AUautosynth/AU-ASM/README.md

Checkout the releases corresponding to the article you came from to get the code and setup information needed to build a machine for yourself.
