AUautosynth/AU-ASM/Towards the automation of nanoparticle syntheses/README.md

# Automatic Synthesis Machine

The purpose of this project is to create a low cost open-source machine for the automation of laboratory work.



## Description

The machine (ASM) consists of a modified 3D printer that can run up to 45 stirred batch reactions at 5.5 ml 
capacity mixing up to 5 different solutions in inert atmosphere. The machine can be seen below.

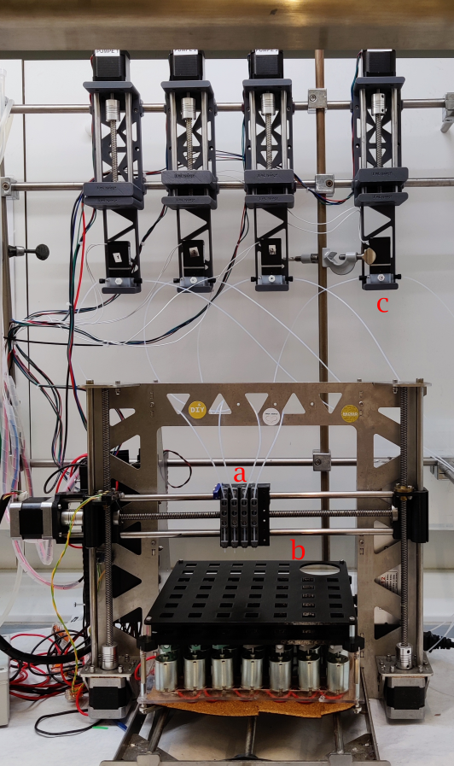
[picture p1: Towards the automation of nanoparticle syntheses/assets/images/Assembledmachine.png]
The machine


The ASM can be seen in the picture above, the new additions have been marked where ***a*** is the dosing head, ***b*** is the cuvette module, 
***c*** are the pumps hanging on fumehood monkey bars.

The estimated cost of the machine is below 2500 EUR, see BoM under assets.
The layout and controlling python scrpit makes it easy to create your own protocols but a standard mixing protocol as well as a 
calibration protocol is already made. To setup and install your own ASM, checkout the PDF guide written. In there, the hardware and software is explained in depth.
The current machine is made up in modules, so that its capabilities can be interchanged based on your needs.

### Modules
The modules of the ASM includes:
- [x] Dosing
- [x] Stirring
- [x] Atmospheric control

## Getting Started

### Dependencies

* Latest [arduino IDE](https://www.arduino.cc/en/software).
* [Python 3.9.7](https://www.python.org/downloads/) or higher.
* For script usage we recommend using either the latest version of [spyder](https://www.spyder-ide.org/) or [pycharm community edition](https://www.jetbrains.com/pycharm/download/#section=windows).
* A 3D printer with a modifiable PCB ([Preferably Ramps 1.4](https://reprap.org/wiki/RAMPS_1.4))
* All necessary CAD and STL files can be found under assets

### Installing

- Download the repository as a .zip file and extract it into a folder.
- Install the modified Marlin firmware on the 3D printer PCB found in the firmware folder.

### Using the machine
This shows a standard procedure for the operation of an experiment using the machine.

1. Create the experiment protocol.
2. Add vials and tubing to the machine.
3. Prepare the stock solutions.
4. Press run.

## Authors
Jakob Saugbjerg (jrs@bce.au.dk)

Thorbjørn Jensen (tbj@bce.au.dk)

Mogens Hinge (hinge@bce.au.dk)

Martin Lahn (lahn@bce.au.dk)

## Version History

* 2.0
   * Integrated the protocol creator into the python software
   * Added a timed start to the protocol
   * Added a control feature to adjust the X, Y and Z axis.
   * Adjusted the pump setup so they can pump high viscosity liquids (Glycose 80%) and smaller dosings (20 microliters)

* 1.0
    * Initial Release

## License

MIT License

Copyright (c) 2023 Jakob Rørbæk Saugbjerg, Thorbjørn Bøgh Jensen, Mogens Hinge & Martin Lahn

Permission is hereby granted, free of charge, to any person obtaining a copy
of this software and associated documentation files (the "Software"), to deal
in the Software without restriction, including without limitation the rights
to use, copy, modify, merge, publish, distribute, sublicense, and/or sell
copies of the Software, and to permit persons to whom the Software is
furnished to do so, subject to the following conditions:

The above copyright notice and this permission notice shall be included in all
copies or substantial portions of the Software.

THE SOFTWARE IS PROVIDED "AS IS", WITHOUT WARRANTY OF ANY KIND, EXPRESS OR
IMPLIED, INCLUDING BUT NOT LIMITED TO THE WARRANTIES OF MERCHANTABILITY,
FITNESS FOR A PARTICULAR PURPOSE AND NONINFRINGEMENT. IN NO EVENT SHALL THE
AUTHORS OR COPYRIGHT HOLDERS BE LIABLE FOR ANY CLAIM, DAMAGES OR OTHER
LIABILITY, WHETHER IN AN ACTION OF CONTRACT, TORT OR OTHERWISE, ARISING FROM,
OUT OF OR IN CONNECTION WITH THE SOFTWARE OR THE USE OR OTHER DEALINGS IN THE
SOFTWARE.
