AUautosynth/AU-ASM/A modular low-cost ASM demonstrated by ROMP/assets/BoM/BoM.xlsx

BoM:
Description | Quantity | Location | Notes | Cost [DKK]
General
3D printer | 1 |  | We used a Prisa i3 clone with an Arduino Mega and a Ramps 1.4 shield attached | 3 500
1.75 mm PLA filament | 1 spool (1 000 g) |  | For production of barious parts | 170
Wires | a lot |  |  | 36
RampsXB | 1 | Attachment to the Ramps 1.4 shield | RampsXB is an experied product, similar boards can be used (e.g. Ramps stepper expander) | -
M3 screws | a lot | All threads are made for m# screws in various lengths | Get a set from 3 to 20 mm | 150
Mechanical end-stop |  | Replaces the induction sensor for the Z.axis |  | 80
Polycarbonate sheets, 3mm | about 1 m2 | Stirring and inert modules |  | 299
Dosage module
Custom pump | 1-5 | Attaches to the machine | Similar pump sustems can be used | 500 per pump
Bükert three-way solenoid valve | 1 per pump | Placed on the pump | Controls the flow direction | 1 061
Tube fittings | 3 per valve | Fits the ports on the valve |  | 66
Silicone tubing 4 mm ID | a lot | Pump module | Connects stock solutions to the machine | 450 for 7.6 m
BlueCap flask 250 mL | 1 per pump | Connected to the valve | Contains stock solution | 25 per flask
Special cannula | 1 per pump | Connects the BlueCap to tubing |  | 20 per needle
Rubber septum | 1 per pump | BlueCap lid | Selas the modified BlueCap lid | 20 per septum
50 x 0.8 mm 21g sterile syringe | 1 box (100 pcs) | In the needle module | Different needles can be used with slight modifications | 34
Stirring module
12 DC motors | 45 | Stirring module |  | 1 750
Teflon coated magnets 20x6 mm | 45 | Stirring module |  | 608
Teflon coated 45 magnets 15x4.5 mm | 45 | Stirring module |  | 428
PWM controller | 3 | Stirring module |  | 300
ABS box | 1 | Stirring module | Holds the PWM controllers | 79
Atmosphere control module
Luer lock male and female set | 10 sets | In the silicone tubing and for gas inlet in the atmosphere control module |  | 100
Total cost | With 1 pump |  |  | 9 676 ≈ 1 300 EUR
 | With 5 pumps |  |  | 16 439 ≈ 2 205 EUR
