AUautosynth/AU-ASM/A modular low-cost ASM demonstrated by ROMP/assets/STL files/needle holder.stl

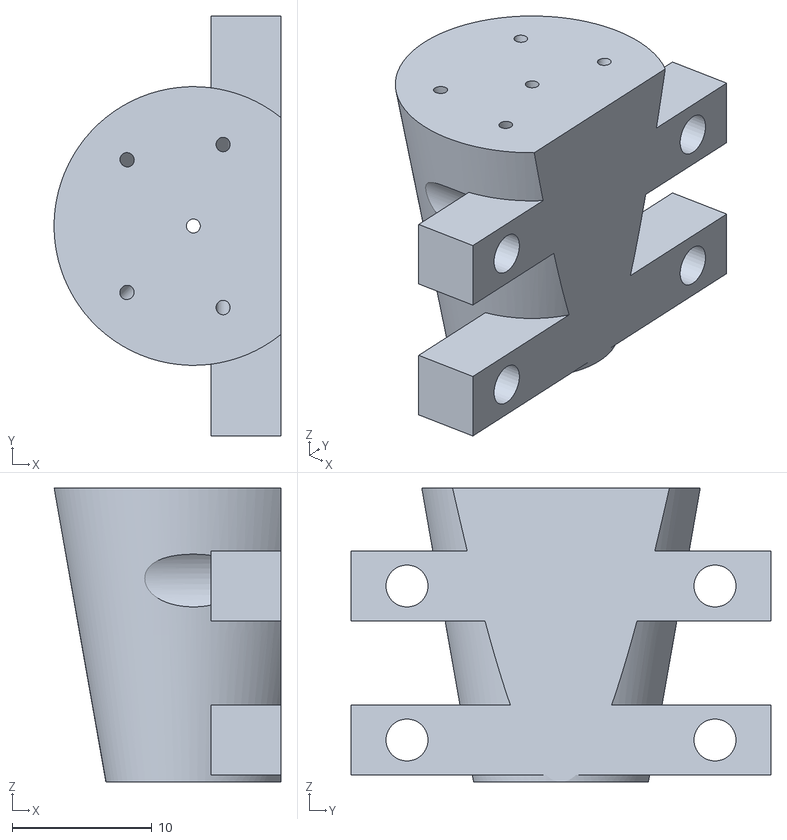
[picture p3: CAD file, 2023-05-10]
A modular low-cost ASM demonstrated by ROMP/assets/STL files/needle holder.stl
16.2 x 30.0 x 21.0
