AUautosynth/AU-ASM/assets/STL files/pump modification.stl

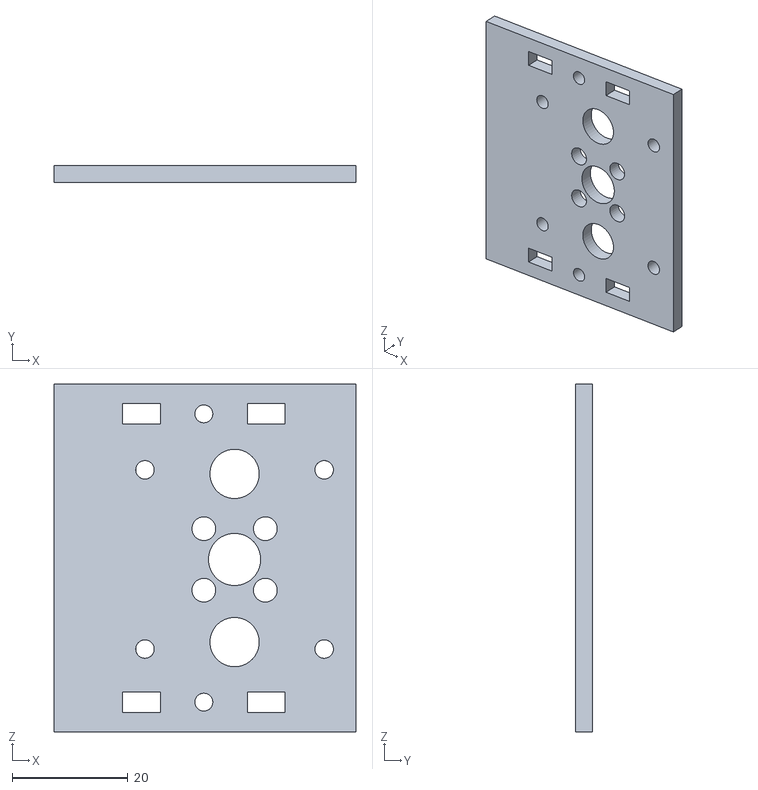
[picture p4: CAD file, 2023-05-10]
assets/STL files/pump modification.stl
52.0 x 3.00 x 60.0
