AUautosynth/AU-ASM/Towards the automation of nanoparticle syntheses/assets/IPT/DH_Gantry.stl

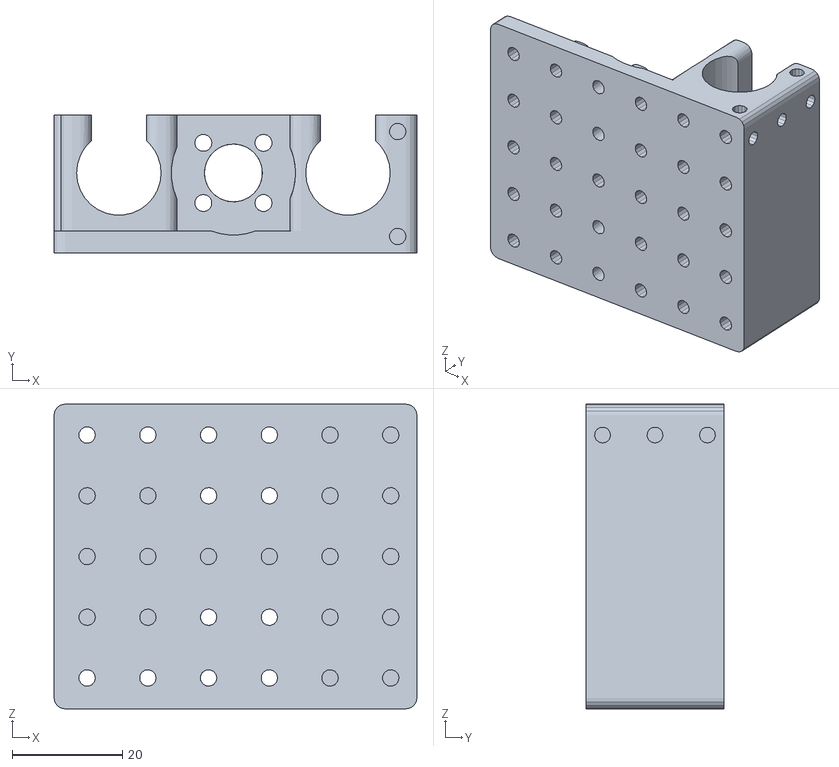
[picture p6: CAD file, 2023-10-06]
Towards the automation of nanoparticle syntheses/assets/IPT/DH_Gantry.stl
65.8 x 25.0 x 55.2
