AUautosynth/AU-ASM/A modular low-cost ASM demonstrated by ROMP/assets/STL files/X-endstop bar.stl

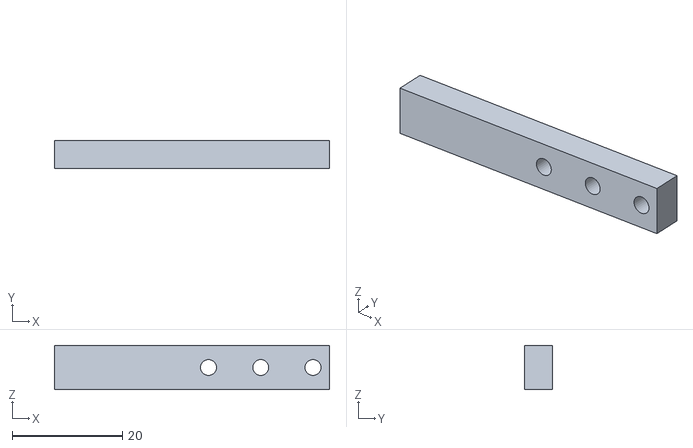
[picture p7: CAD file, 2023-05-10]
A modular low-cost ASM demonstrated by ROMP/assets/STL files/X-endstop bar.stl
50.0 x 5.00 x 8.00
