AUautosynth/AU-ASM/Towards the automation of nanoparticle syntheses/assets/IPT/CM_top.stl

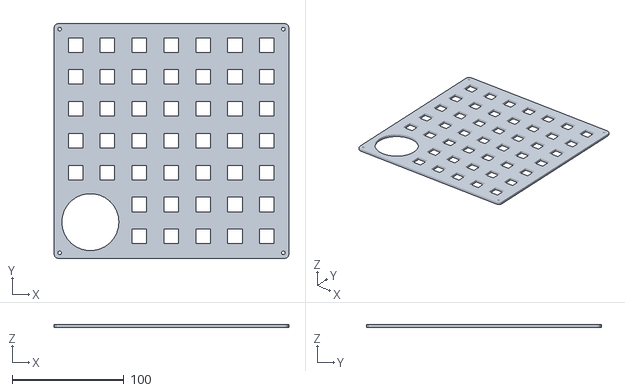
[picture p9: CAD file, 2023-10-06]
Towards the automation of nanoparticle syntheses/assets/IPT/CM_top.stl
210.0 x 210.0 x 3.00
