AUautosynth/AU-ASM/A modular low-cost ASM demonstrated by ROMP/assets/STL files/valve fixture.stl

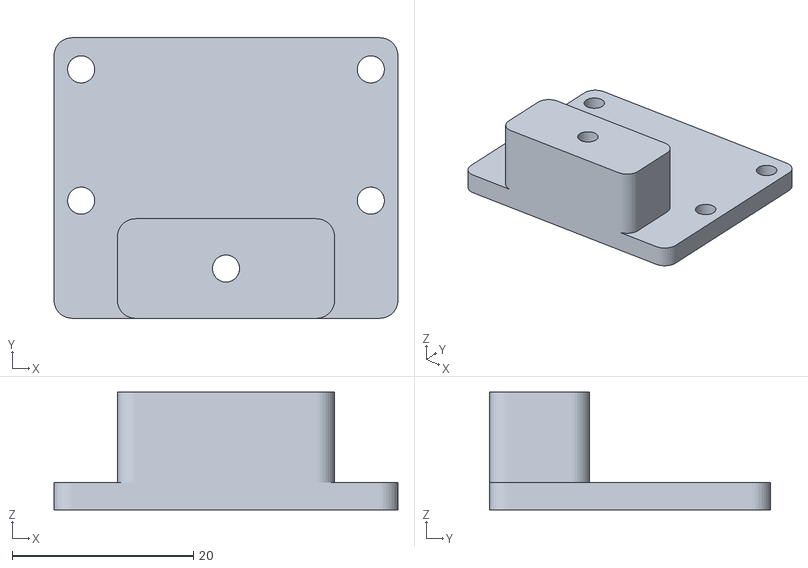
[picture p10: CAD file, 2023-05-10]
A modular low-cost ASM demonstrated by ROMP/assets/STL files/valve fixture.stl
38.0 x 31.0 x 13.0
