AUautosynth/AU-ASM/assets/STL files/magnet fixture.stl

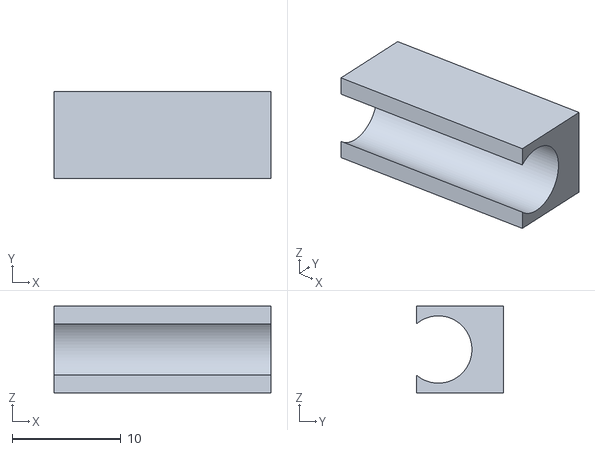
[picture p11: CAD file, 2023-05-10]
assets/STL files/magnet fixture.stl
20.0 x 8.00 x 8.00
