AUautosynth/AU-ASM/The Perry project A Versatile Low-Cost Syringe Pump for Dispensing in Automated Synthesis Systems/STL/Perry_syringe_fitter_5mL.stl

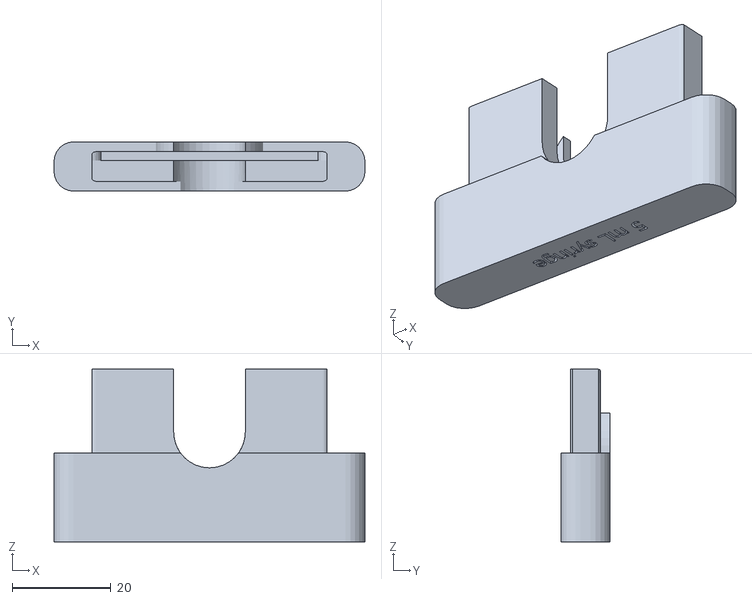
[picture p12: CAD file, 2023-10-06]
The Perry project A Versatile Low-Cost Syringe Pump for Dispensing in Automated Synthesis Systems/STL/Perry_syringe_fitter_5mL.stl
63.0 x 10.0 x 35.0
