AUautosynth/AU-ASM/Towards the automation of nanoparticle syntheses/assets/IPT/DH_tubing_holder.stl

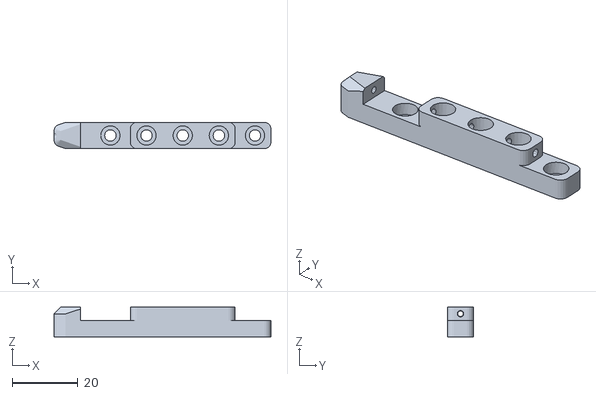
[picture p13: CAD file, 2023-10-06]
Towards the automation of nanoparticle syntheses/assets/IPT/DH_tubing_holder.stl
66.0 x 8.00 x 9.00
