AUautosynth/AU-ASM/A modular low-cost ASM demonstrated by ROMP/assets/STL files/pump sledge.stl

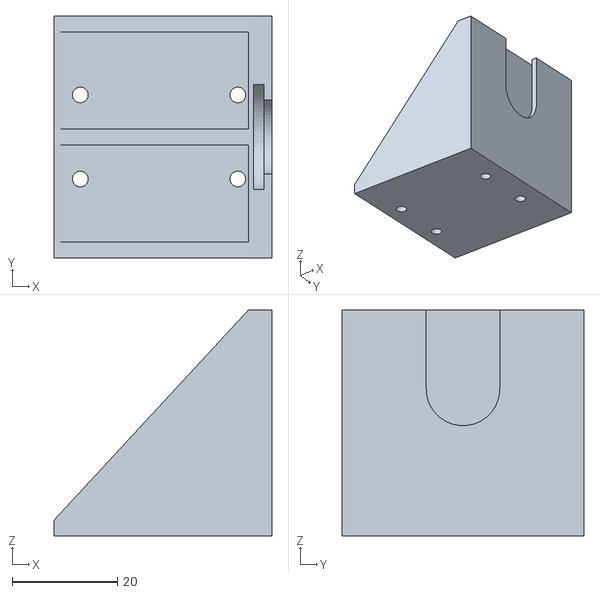
[picture p14: CAD file, 2023-05-10]
A modular low-cost ASM demonstrated by ROMP/assets/STL files/pump sledge.stl
41.5 x 46.0 x 43.0
