AUautosynth/AU-ASM/The Perry project A Versatile Low-Cost Syringe Pump for Dispensing in Automated Synthesis Systems/STL/Perry_plunge_fitter_5ml.stl

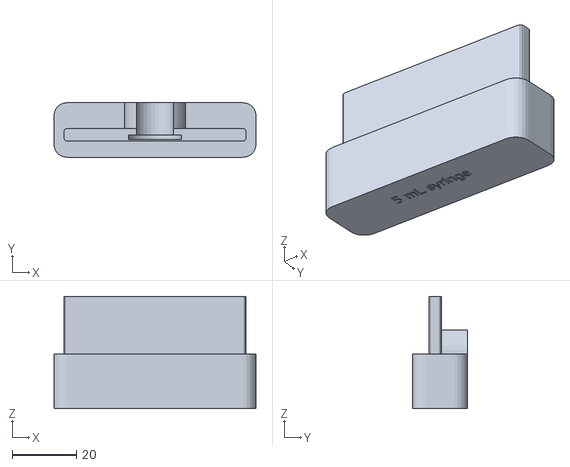
[picture p15: CAD file, 2023-10-06]
The Perry project A Versatile Low-Cost Syringe Pump for Dispensing in Automated Synthesis Systems/STL/Perry_plunge_fitter_5ml.stl
63.0 x 17.0 x 35.0
