AUautosynth/AU-ASM/Towards the automation of nanoparticle syntheses/assets/IPT/CM_bottom.stl

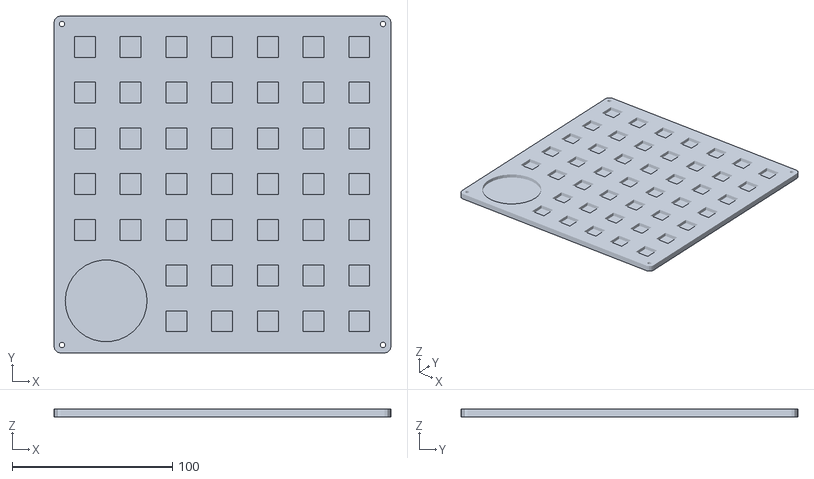
[picture p16: CAD file, 2023-10-06]
Towards the automation of nanoparticle syntheses/assets/IPT/CM_bottom.stl
210.0 x 210.0 x 5.00
