AUautosynth/AU-ASM/Towards the automation of nanoparticle syntheses/assets/IPT/CM_corner_piece.stl

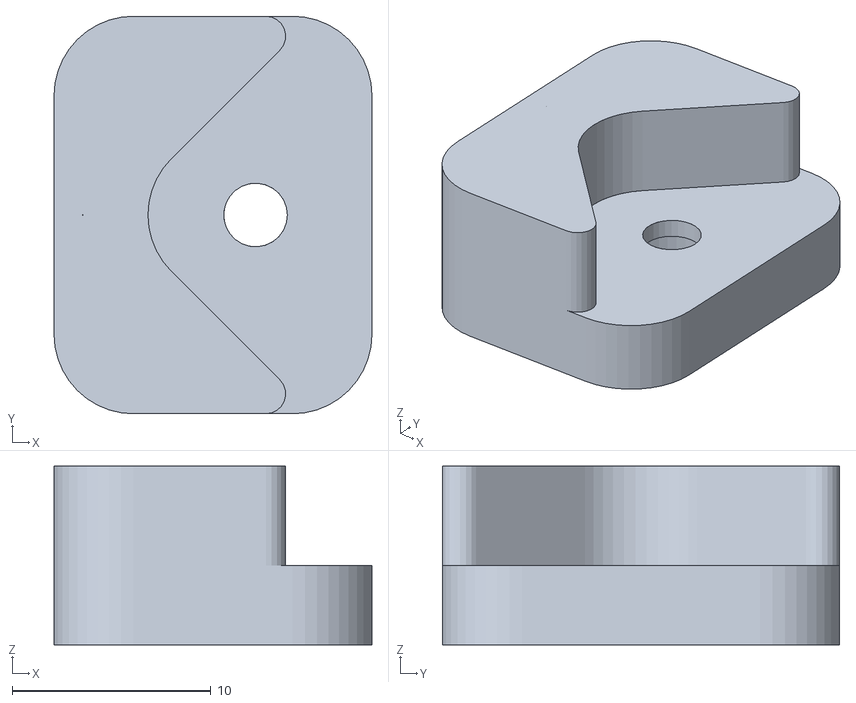
[picture p18: CAD file, 2023-10-06]
Towards the automation of nanoparticle syntheses/assets/IPT/CM_corner_piece.stl
16.0 x 20.0 x 9.00
