AUautosynth/AU-ASM/(list of files, cad)

Other CAD files:
A modular low-cost ASM demonstrated by ROMP/assets/STL files/X-carriage.stl
assets/STL files/X-carriage.stl
The Perry project A Versatile Low-Cost Syringe Pump for Dispensing in Automated Synthesis Systems/STL/Perry_plunge_fitter_20ml.stl
A modular low-cost ASM demonstrated by ROMP/assets/CAD files/ACM_BasePlate.ipt
A modular low-cost ASM demonstrated by ROMP/assets/CAD files/ACM_InsertPlate.ipt
A modular low-cost ASM demonstrated by ROMP/assets/CAD files/ACM_Lid.ipt
A modular low-cost ASM demonstrated by ROMP/assets/CAD files/ACM_Side.ipt
A modular low-cost ASM demonstrated by ROMP/assets/CAD files/ACM_SupportColumn1.ipt
A modular low-cost ASM demonstrated by ROMP/assets/CAD files/ACM_SupportColumn2.ipt
A modular low-cost ASM demonstrated by ROMP/assets/CAD files/DM_DirectMotorMount.ipt
A modular low-cost ASM demonstrated by ROMP/assets/CAD files/DM_NeedleHolder.ipt
A modular low-cost ASM demonstrated by ROMP/assets/CAD files/SM_DCholder.ipt
A modular low-cost ASM demonstrated by ROMP/assets/CAD files/SM_MagnetHolder.ipt
The Perry project A Versatile Low-Cost Syringe Pump for Dispensing in Automated Synthesis Systems/Assembly/Perry_Assembly.iam
The Perry project A Versatile Low-Cost Syringe Pump for Dispensing in Automated Synthesis Systems/IPT/Perry_body.ipt
The Perry project A Versatile Low-Cost Syringe Pump for Dispensing in Automated Synthesis Systems/IPT/Perry_hanger_left.ipt
The Perry project A Versatile Low-Cost Syringe Pump for Dispensing in Automated Synthesis Systems/IPT/Perry_hanger_right.ipt
The Perry project A Versatile Low-Cost Syringe Pump for Dispensing in Automated Synthesis Systems/IPT/Perry_plunge_fitter_10ml.ipt
The Perry project A Versatile Low-Cost Syringe Pump for Dispensing in Automated Synthesis Systems/IPT/Perry_plunge_fitter_1ml.ipt
The Perry project A Versatile Low-Cost Syringe Pump for Dispensing in Automated Synthesis Systems/IPT/Perry_plunge_fitter_20ml.ipt
The Perry project A Versatile Low-Cost Syringe Pump for Dispensing in Automated Synthesis Systems/IPT/Perry_plunge_fitter_2ml.ipt
The Perry project A Versatile Low-Cost Syringe Pump for Dispensing in Automated Synthesis Systems/IPT/Perry_plunge_fitter_5ml.ipt
The Perry project A Versatile Low-Cost Syringe Pump for Dispensing in Automated Synthesis Systems/IPT/Perry_plunger.ipt
The Perry project A Versatile Low-Cost Syringe Pump for Dispensing in Automated Synthesis Systems/IPT/Perry_syringe_fitter_10mL.ipt
The Perry project A Versatile Low-Cost Syringe Pump for Dispensing in Automated Synthesis Systems/IPT/Perry_syringe_fitter_1mL.ipt
The Perry project A Versatile Low-Cost Syringe Pump for Dispensing in Automated Synthesis Systems/IPT/Perry_syringe_fitter_20mL.ipt
The Perry project A Versatile Low-Cost Syringe Pump for Dispensing in Automated Synthesis Systems/IPT/Perry_syringe_fitter_2mL.ipt
The Perry project A Versatile Low-Cost Syringe Pump for Dispensing in Automated Synthesis Systems/IPT/Perry_syringe_fitter_5mL.ipt
The Perry project A Versatile Low-Cost Syringe Pump for Dispensing in Automated Synthesis Systems/IPT/Perry_valve_fixture.ipt
Towards the automation of nanoparticle syntheses/assets/Assembly/CM_Assembly.iam
Towards the automation of nanoparticle syntheses/assets/Assembly/CM_Assembly_Presentation.idw
Towards the automation of nanoparticle syntheses/assets/Assembly/DH_Assembly.iam
Towards the automation of nanoparticle syntheses/assets/Assembly/DH_Assembly_Presentation.idw
Towards the automation of nanoparticle syntheses/assets/Assembly/Perry_Assembly.iam
Towards the automation of nanoparticle syntheses/assets/Assembly/Perry_Assembly_Presentation.idw
Towards the automation of nanoparticle syntheses/assets/IPT/CM_bottom.ipt
Towards the automation of nanoparticle syntheses/assets/IPT/CM_corner_piece.ipt
Towards the automation of nanoparticle syntheses/assets/IPT/CM_top.ipt
Towards the automation of nanoparticle syntheses/assets/IPT/DH_Gantry.ipt
Towards the automation of nanoparticle syntheses/assets/IPT/DH_tubing_holder.ipt
assets/CAD files/ACM_BasePlate.ipt
assets/CAD files/ACM_InsertPlate.ipt
assets/CAD files/ACM_Lid.ipt
assets/CAD files/ACM_Side.ipt
assets/CAD files/ACM_SupportColumn1.ipt
assets/CAD files/ACM_SupportColumn2.ipt
assets/CAD files/DM_DirectMotorMount.ipt
assets/CAD files/DM_NeedleHolder.ipt
assets/CAD files/SM_DCholder.ipt
assets/CAD files/SM_MagnetHolder.ipt
