AUautosynth/AU-ASM/Towards the automation of nanoparticle syntheses/main program/saved protocols/test protocols/Pump calibration - valve_pump.txt

Dosing Method: pump_calibration
Reaction module: Cuvette module
Number of reaction vessels: 45
Max Volume: 3.0
Waste: [180, 180]
Beaker height: 25
Safety height: 65
Vial height: 3
Machine speed: 50
Pump 1: 
index	Solution 1	x-coordinate	y-coordinate
Experiment 1	0.1	28	16.0
Experiment 2	0.5	56	16.0
Experiment 3	0.9	84	16.0
Experiment 4	1.2	113	16.0
Experiment 5	1.5	142	16.0
Experiment 1	0.1	171	16.0
Experiment 2	0.5	199	16.0
Experiment 3	0.9	28	44.0
Experiment 4	1.2	56	44.0
Experiment 5	1.5	84	44.0
Experiment 1	0.1	113	44.0
Experiment 2	0.5	142	44.0
Experiment 3	0.9	171	44.0
Experiment 4	1.2	199	44.0
Experiment 5	1.5	28	72.0
	nan	28	72.0
	nan	56	72.0
	nan	84  72	nan
	nan	113	72.0
	nan	142 72	nan
	nan	171	72.0
	nan	199	100.0
	nan	28  100	nan
	nan	56	100.0
	nan	84	100.0
	nan	113	100.0
	nan	142	100.0
	nan	171	100.0
	nan	199	129.0
	nan	28  129	nan
	nan	56	129.0
	nan	84  129	nan
	nan	113	129.0
	nan	142 129	nan
	nan	171	129.0
	nan	199	129.0
	nan	28 	158.0
	nan	56	158.0
	nan	84 	158.0
	nan	113	158.0
	nan	142	158.0
	nan	28 	186.0
	nan	56	186.0
	nan	84 	186.0
	nan	113	186.0
	nan	142 186	nan
