AUautosynth/AU-ASM/ASM files/Protocol templates/Calibration template.xlsx

Sheet: Dosing sheet
Vials | sol 1 | sol 2 | sol 3 | sol 4 | sol 5 | sol 6 | Totale_volume | x | y
vial 1 | 5 | 0 | 0 | 0 | 0 | 0 | 5 | 18.5 | 11
vial 2 | 5 | 0 | 0 | 0 | 0 | 0 | 5 | 47 | 10.5
vial 3 | 15 | 0 | 0 | 0 | 0 | 0 | 15 | 76 | 10.5
vial 4 | 13 | 0 | 0 | 0 | 0 | 0 | 13 | 104 | 10.5
vial 5 | 2 | 0 | 0 | 0 | 0 | 0 | 2 | 132.5 | 10
vial 6 | 11 | 0 | 0 | 0 | 0 | 0 | 11 | 160 | 10.5
vial 7 | 1 | 0 | 0 | 0 | 0 | 0 | 1 | 189 | 9.5
vial 8 | 20 | 0 | 0 | 0 | 0 | 0 | 20 | 18.5 | 39
vial 9 | 15 | 0 | 0 | 0 | 0 | 0 | 15 | 47 | 39
vial 10 | 13 | 0 | 0 | 0 | 0 | 0 | 13 | 75.5 | 39
vial 11 | 9 | 0 | 0 | 0 | 0 | 0 | 9 | 104.5 | 38
vial 12 | 9 | 0 | 0 | 0 | 0 | 0 | 9 | 132.5 | 38
vial 13 | 4 | 0 | 0 | 0 | 0 | 0 | 4 | 160 | 38
vial 14 | 2 | 0 | 0 | 0 | 0 | 0 | 2 | 189 | 38
vial 15 | 2 | 0 | 0 | 0 | 0 | 0 | 2 | 18 | 67.5
vial 16 | 3 | 0 | 0 | 0 | 0 | 0 | 3 | 48.5 | 67.5
vial 17 | 11 | 0 | 0 | 0 | 0 | 0 | 11 | 76 | 67.5
vial 18 | 13 | 0 | 0 | 0 | 0 | 0 | 13 | 104 | 67
vial 19 | 1 | 0 | 0 | 0 | 0 | 0 | 1 | 132 | 67
vial 20 | 5 | 0 | 0 | 0 | 0 | 0 | 5 | 161 | 66.5
vial 21 | 3 | 0 | 0 | 0 | 0 | 0 | 3 | 189 | 66.5
vial 22 | 15 | 0 | 0 | 0 | 0 | 0 | 15 | 19.5 | 95.75
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
