AUautosynth/AU-ASM/The Perry project A Versatile Low-Cost Syringe Pump for Dispensing in Automated Synthesis Systems/Assembly/Perry_Assembly.pdf

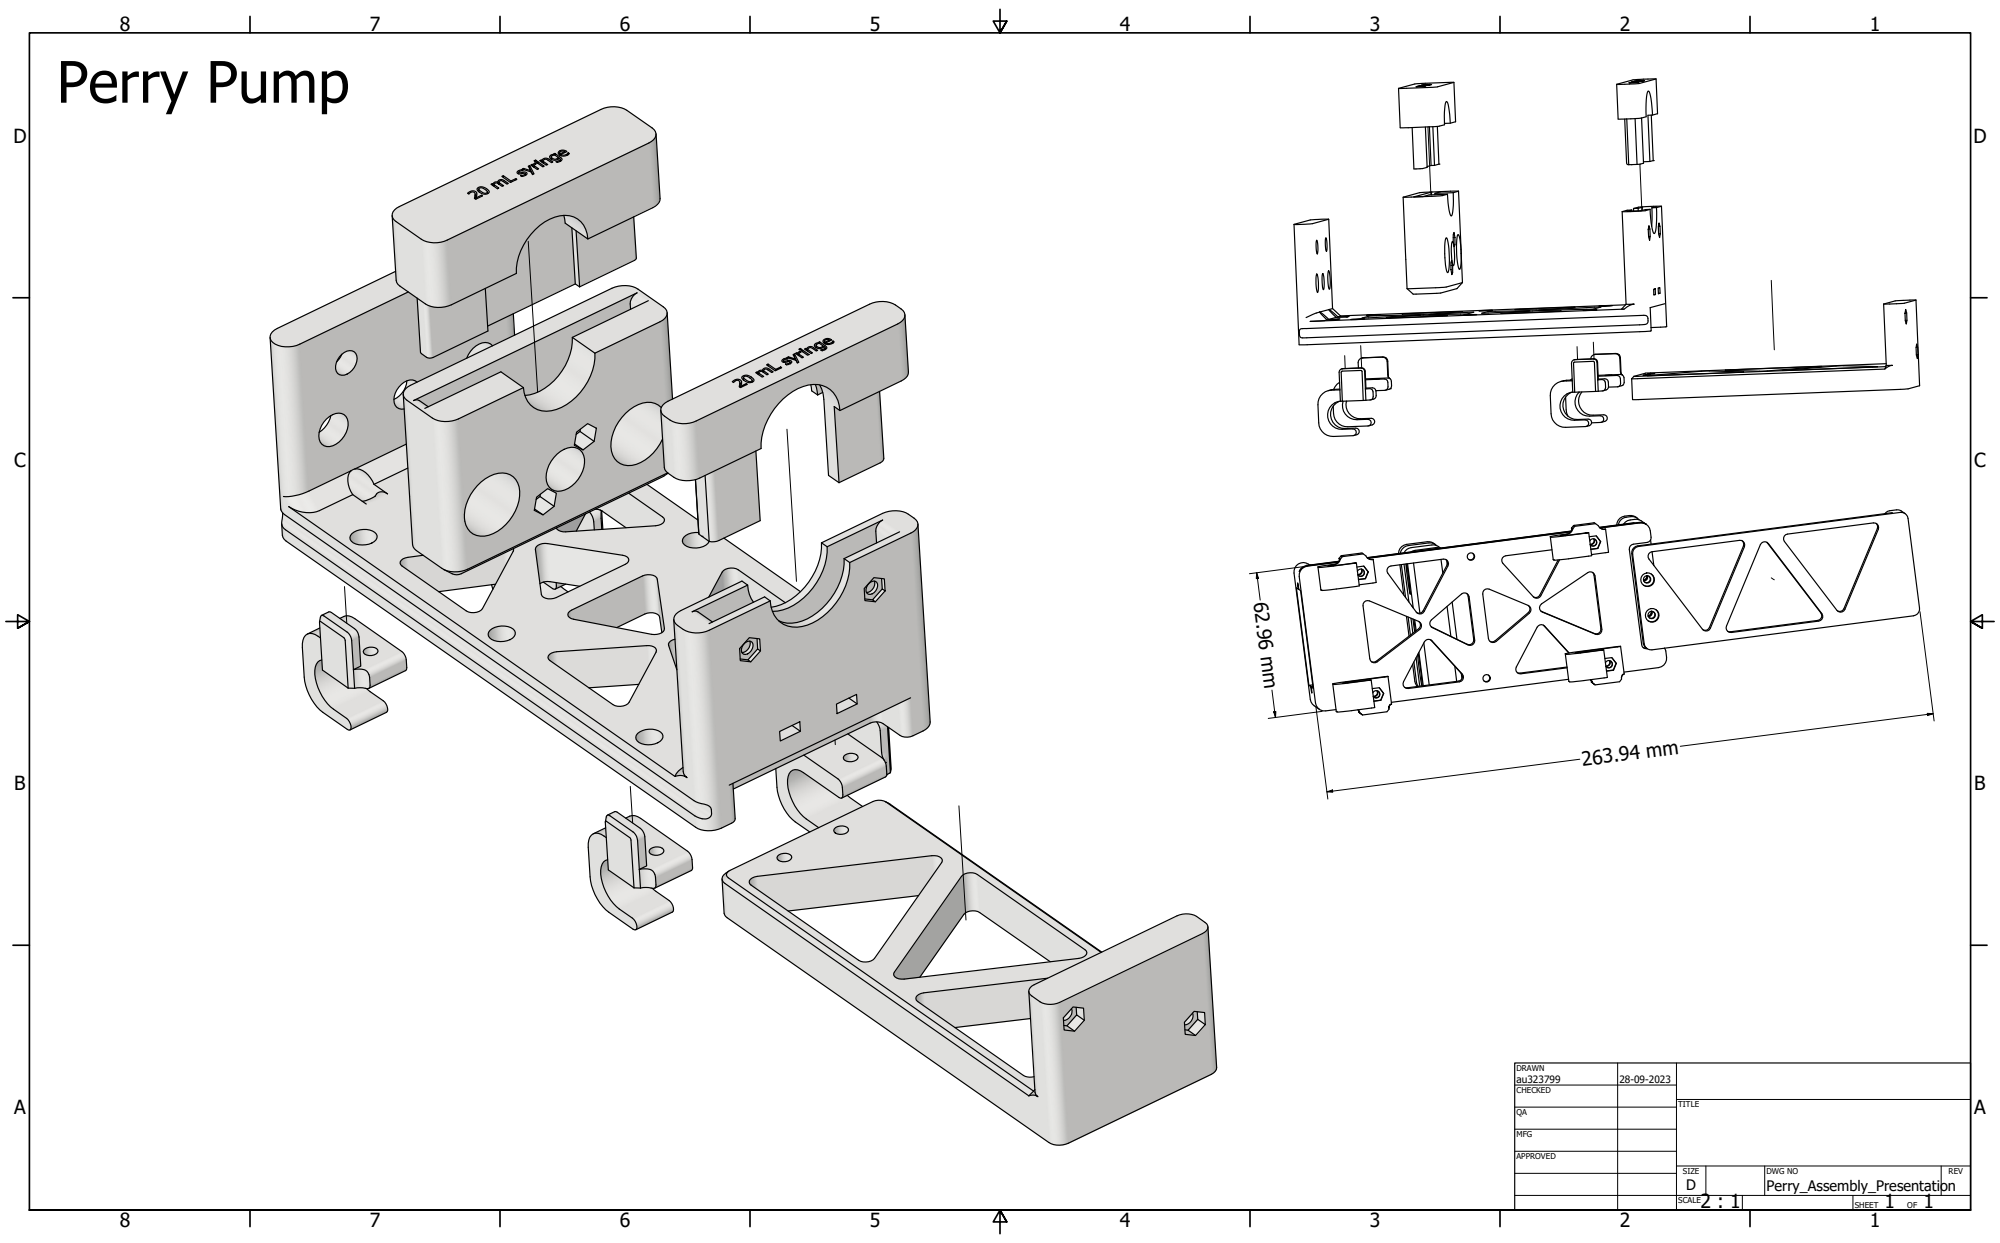
[picture p28: page 1]
Perry Pump

DRAWN au323799 | 28-09-2023

CHECKED

MFG

APPROVED

SIZE D | DWG NO Perry_Assembly_Presentation | REV

2 : 1 SCALE | | SHEET 1 OF 1
