AUautosynth/AU-ASM/A modular low-cost ASM demonstrated by ROMP/assets/CAD files/ACM_BasePlate.pdf

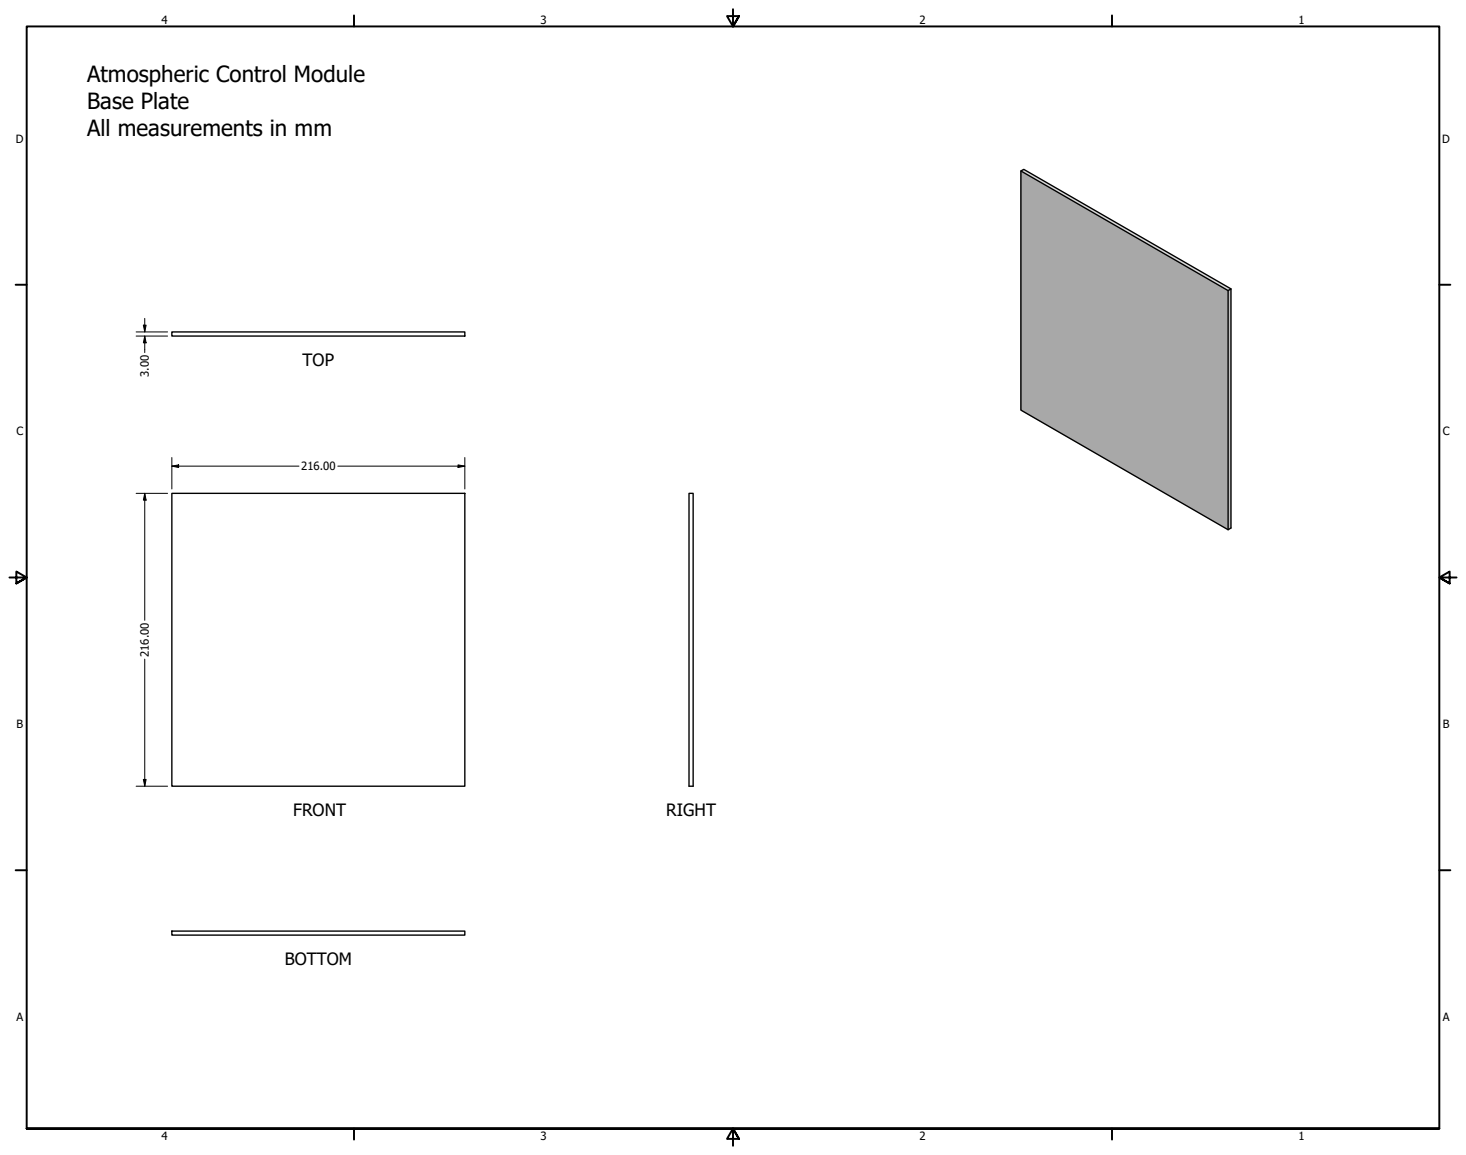
[picture p29: page 1]

Atmospheric Control Module
Base Plate
All measurements in mm
