AUautosynth/AU-ASM/A modular low-cost ASM demonstrated by ROMP/assets/CAD files/ACM_InsertPlate.pdf

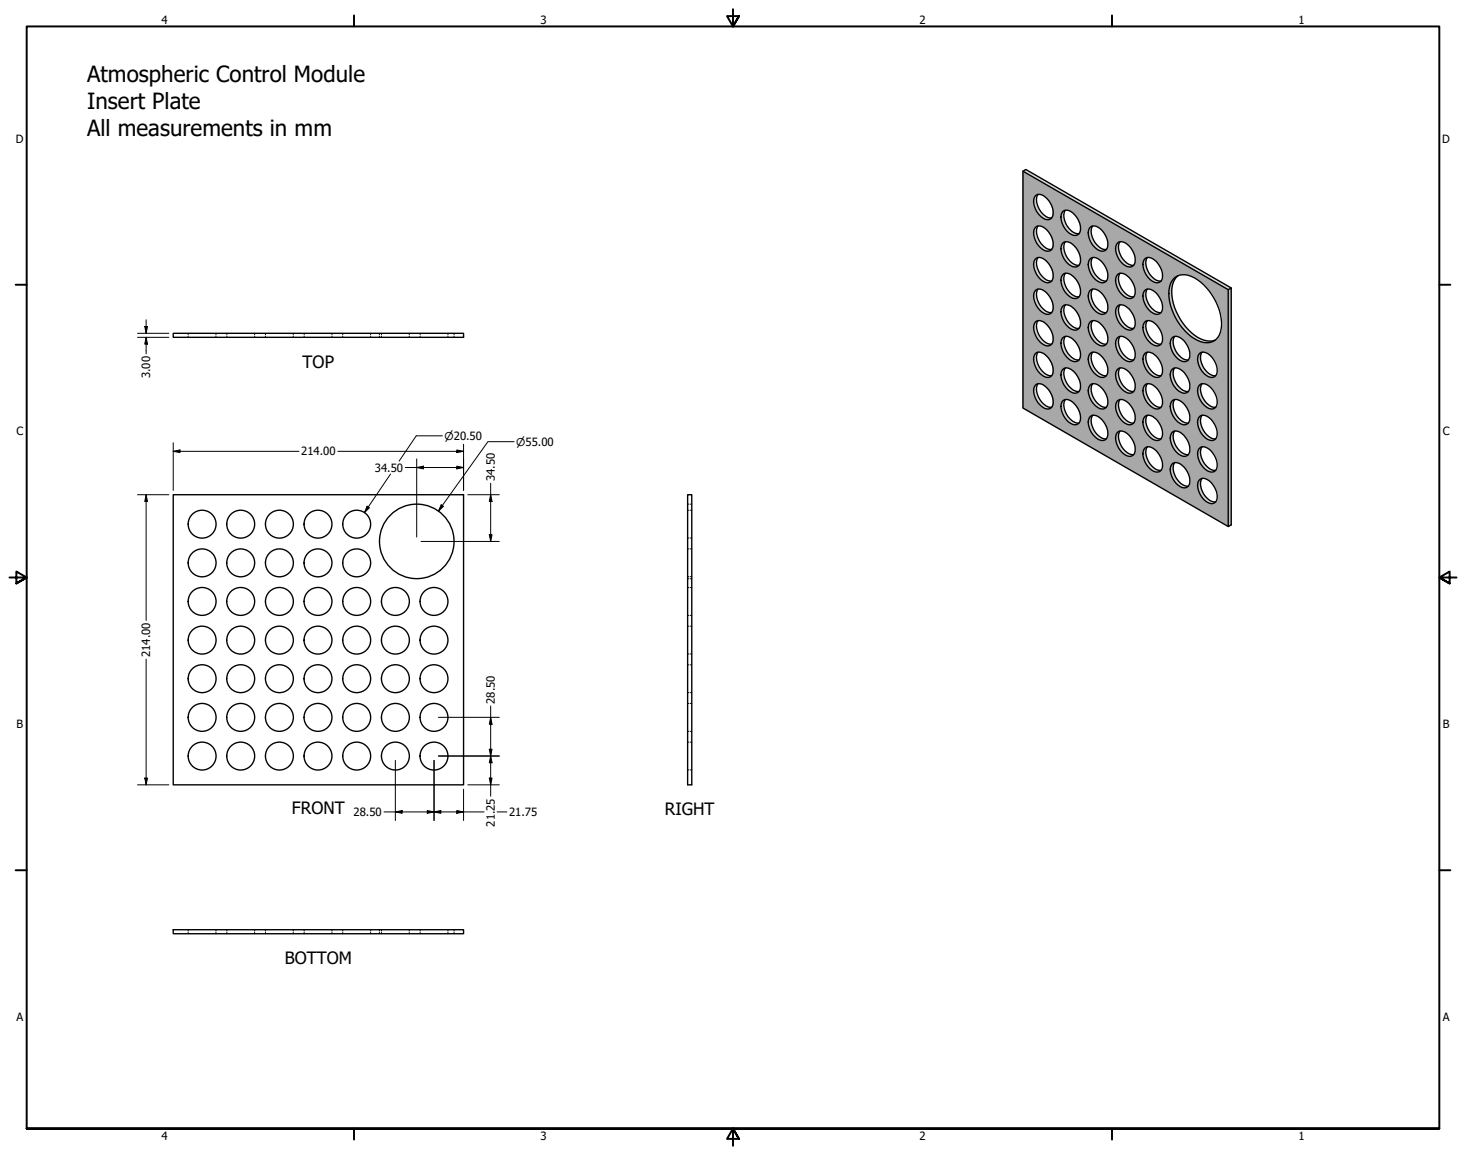
[picture p30: page 1]

Atmospheric Control Module
Insert Plate
All measurements in mm
