AUautosynth/AU-ASM/A modular low-cost ASM demonstrated by ROMP/assets/CAD files/SM_MagnetHolder.pdf

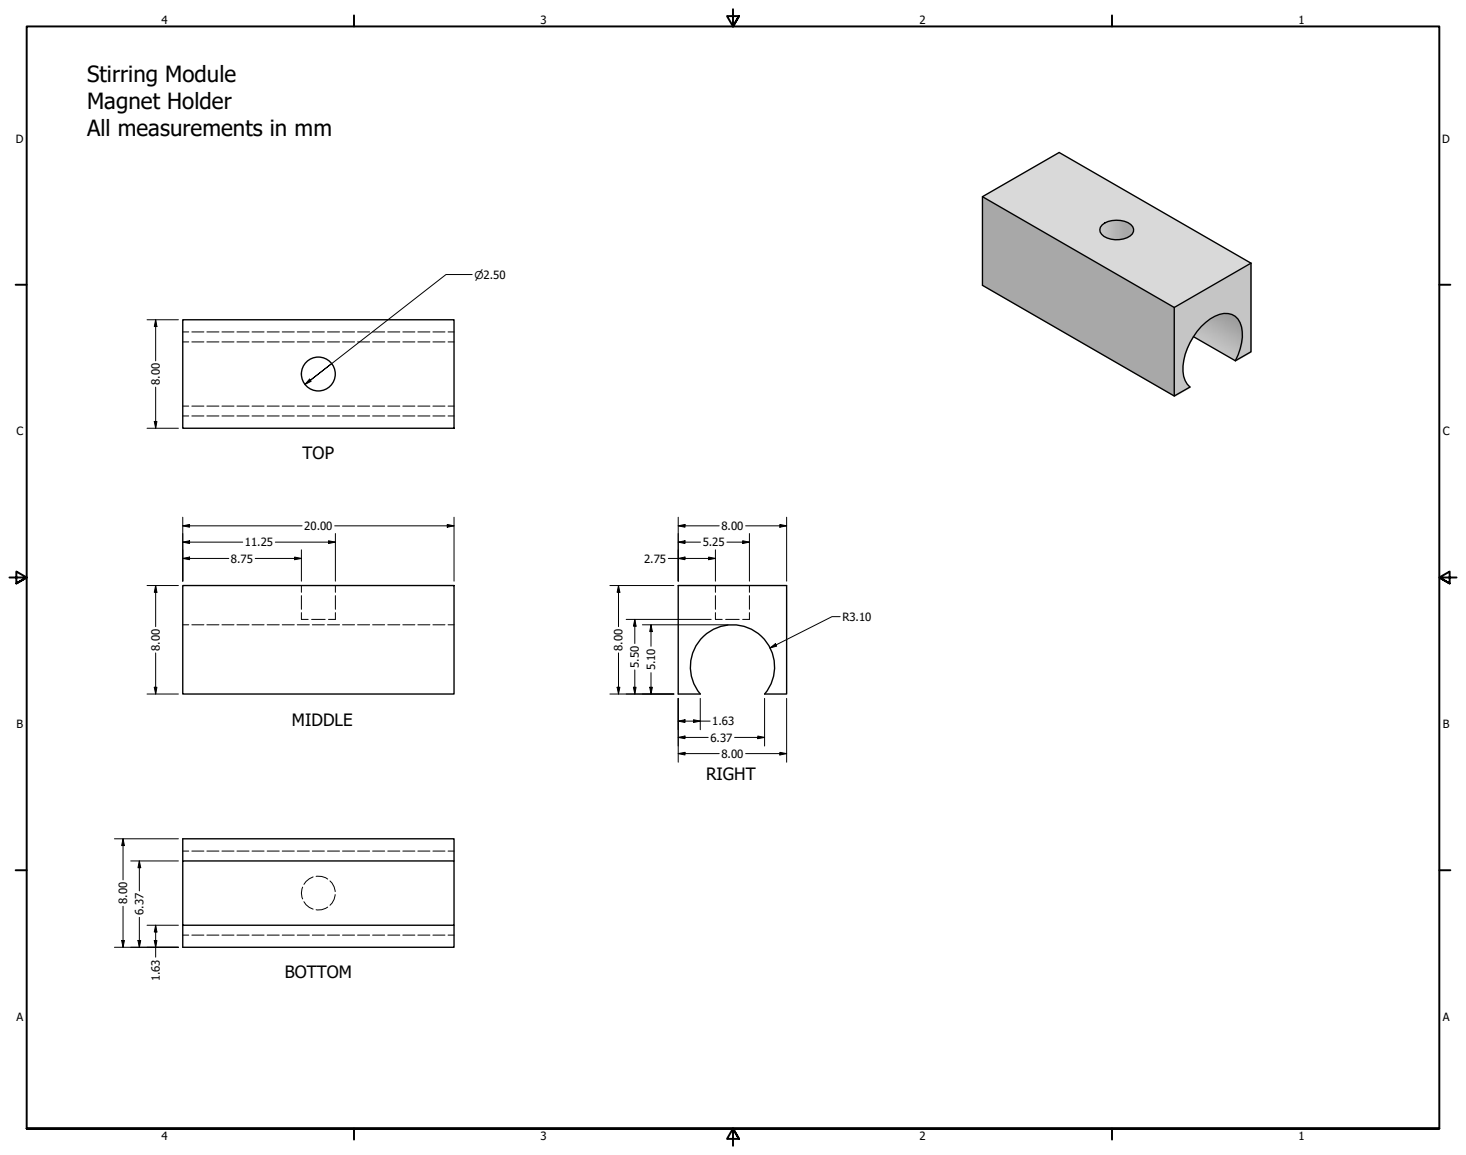
[picture p31: page 1]

Stirring Module
Magnet Holder
All measurements in mm
