AUautosynth/AU-ASM/Towards the automation of nanoparticle syntheses/assets/Assembly/CM_Assembly_Presentation.pdf

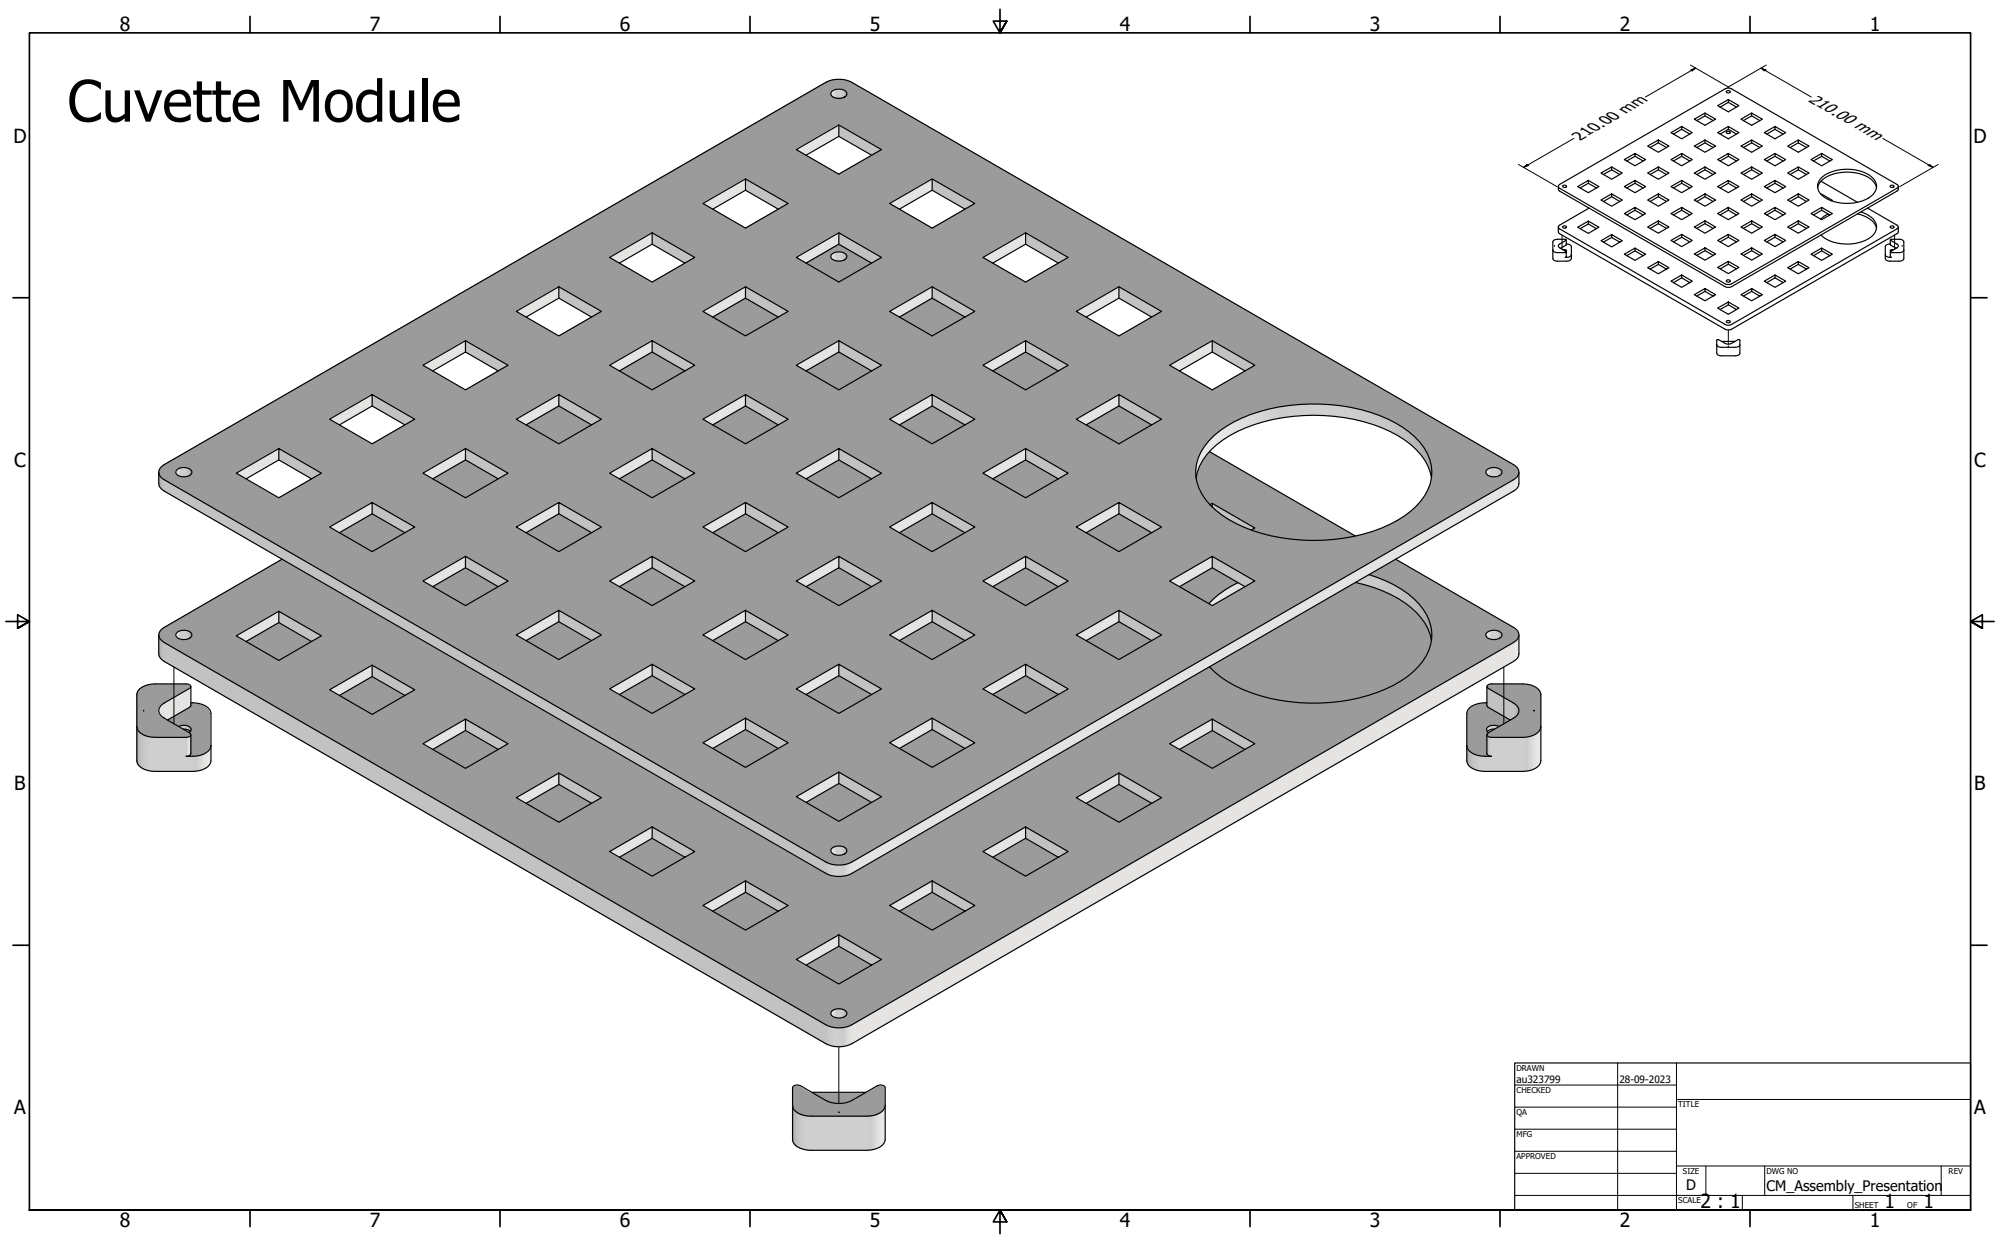
[picture p32: page 1]
vette Module

DRAWN au323799 | 28-09-2023

CHECKED

MFG

APPROVED

SIZE D | DWG NO CM_Assembly_Presentation | REV

2 : 1 SCALE | | SHEET 1 OF 1
