AUautosynth/AU-ASM/Towards the automation of nanoparticle syntheses/assets/Assembly/DH_Assembly_Presentation.pdf

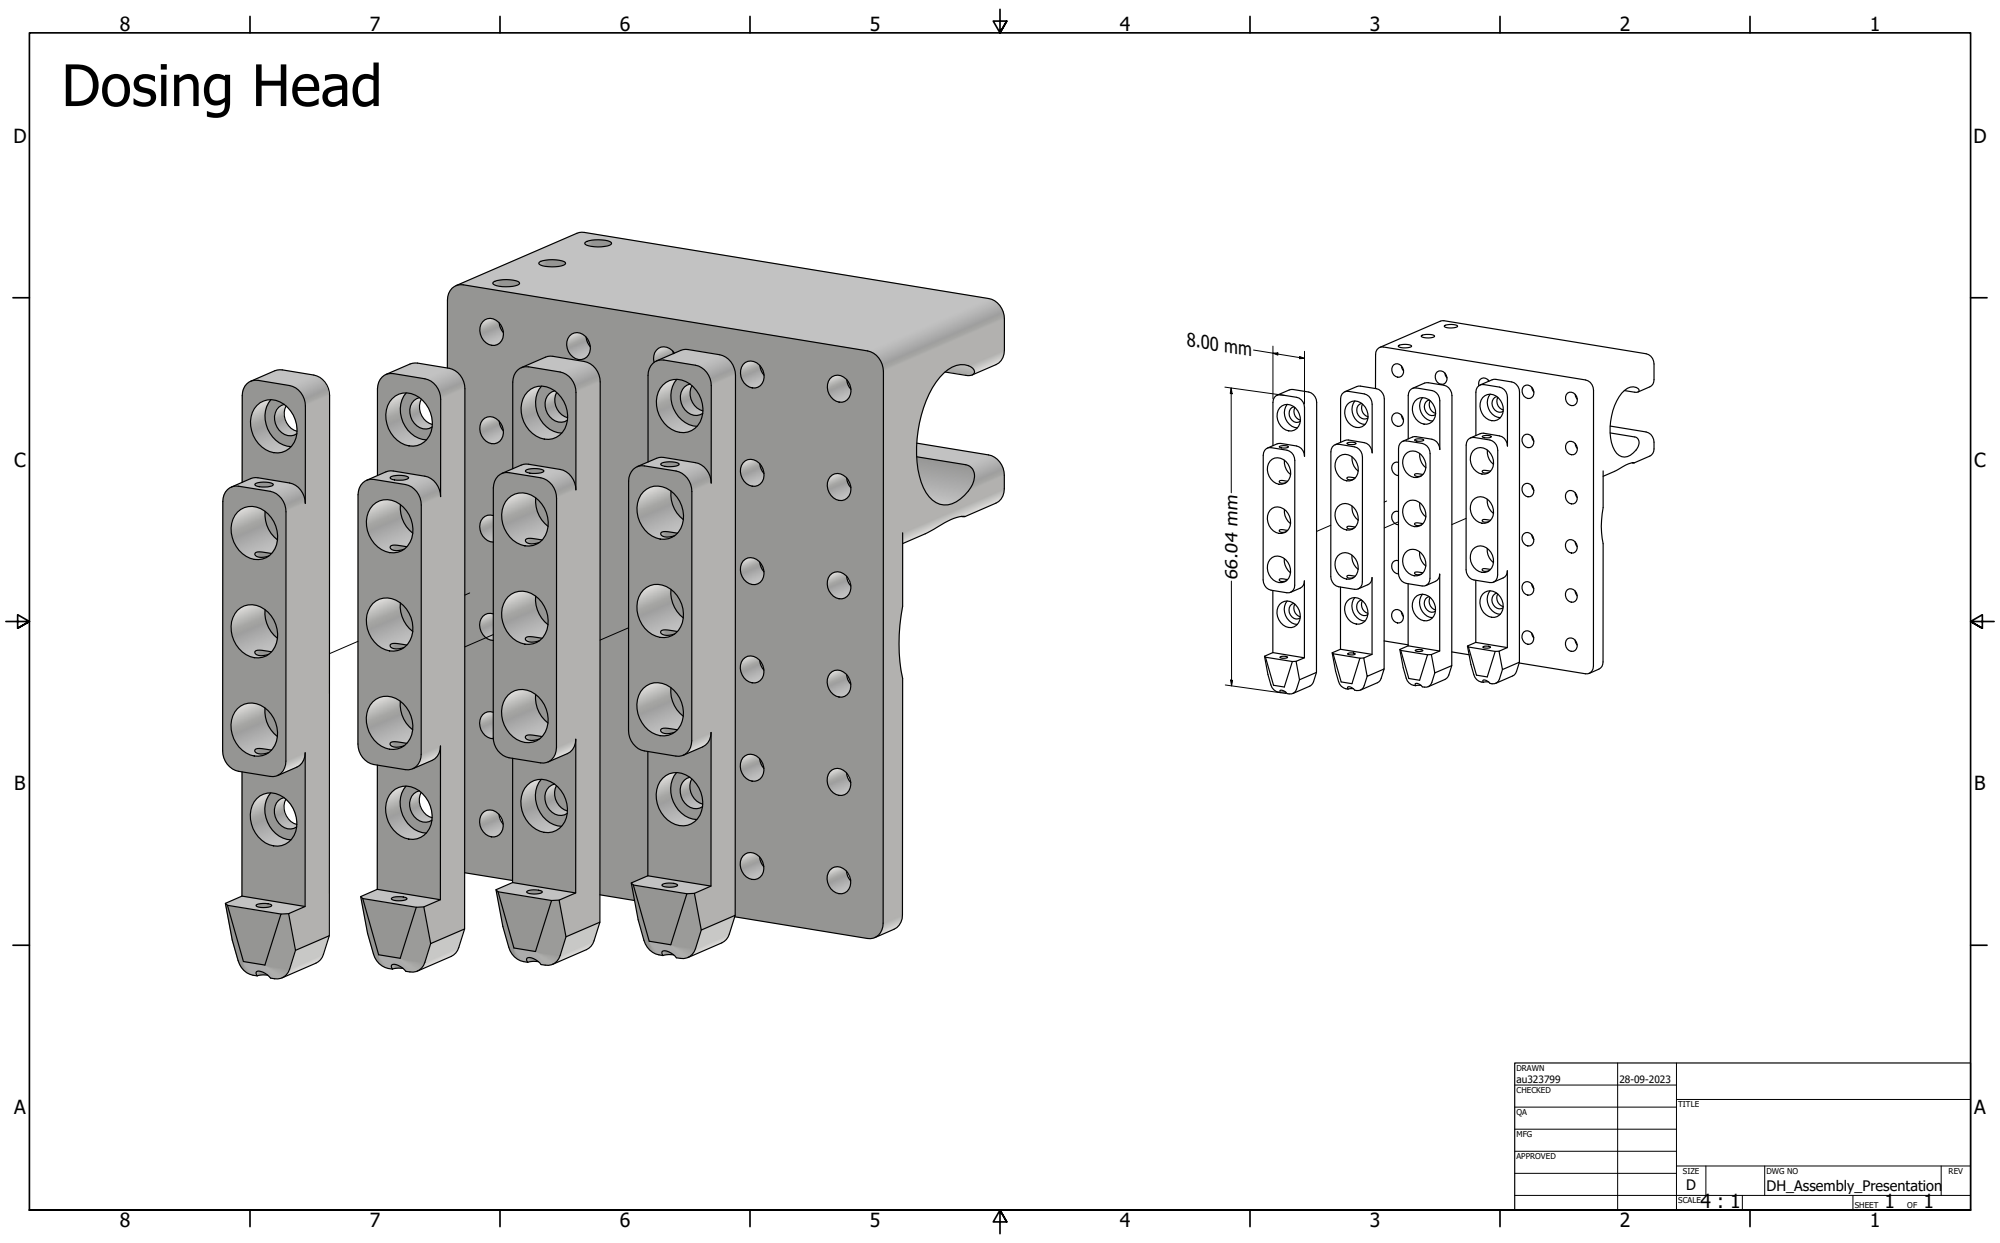
[picture p33: page 1]
Dosing Head

DRAWN au323799 | 28-09-2023

CHECKED

MFG

APPROVED

SIZE D | DWG NO DH_Assembly_Presentation | REV

4 : 1 SCALE | | SHEET 1 OF 1
