AUautosynth/AU-ASM/A modular low-cost ASM demonstrated by ROMP/assets/CAD files/ACM_Lid.pdf

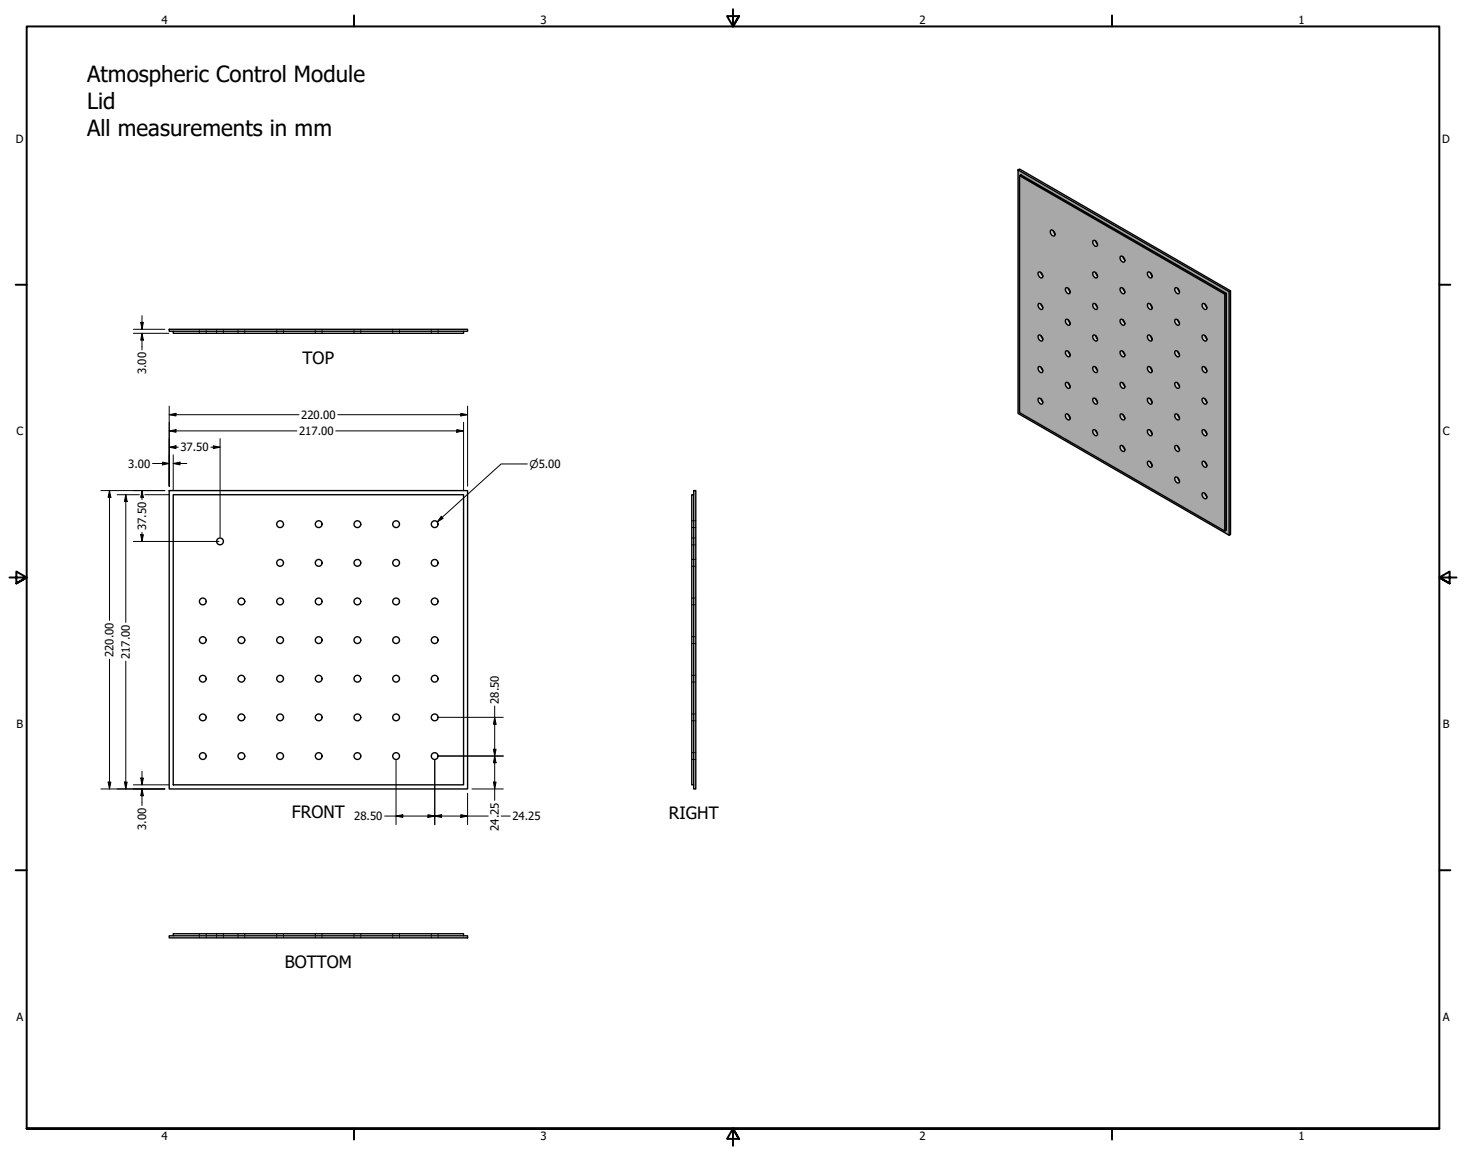
[picture p34: page 1]

Atmospheric Control Module
Lid
All measurements in mm
