AUautosynth/AU-ASM/A modular low-cost ASM demonstrated by ROMP/assets/CAD files/ACM_Side.pdf

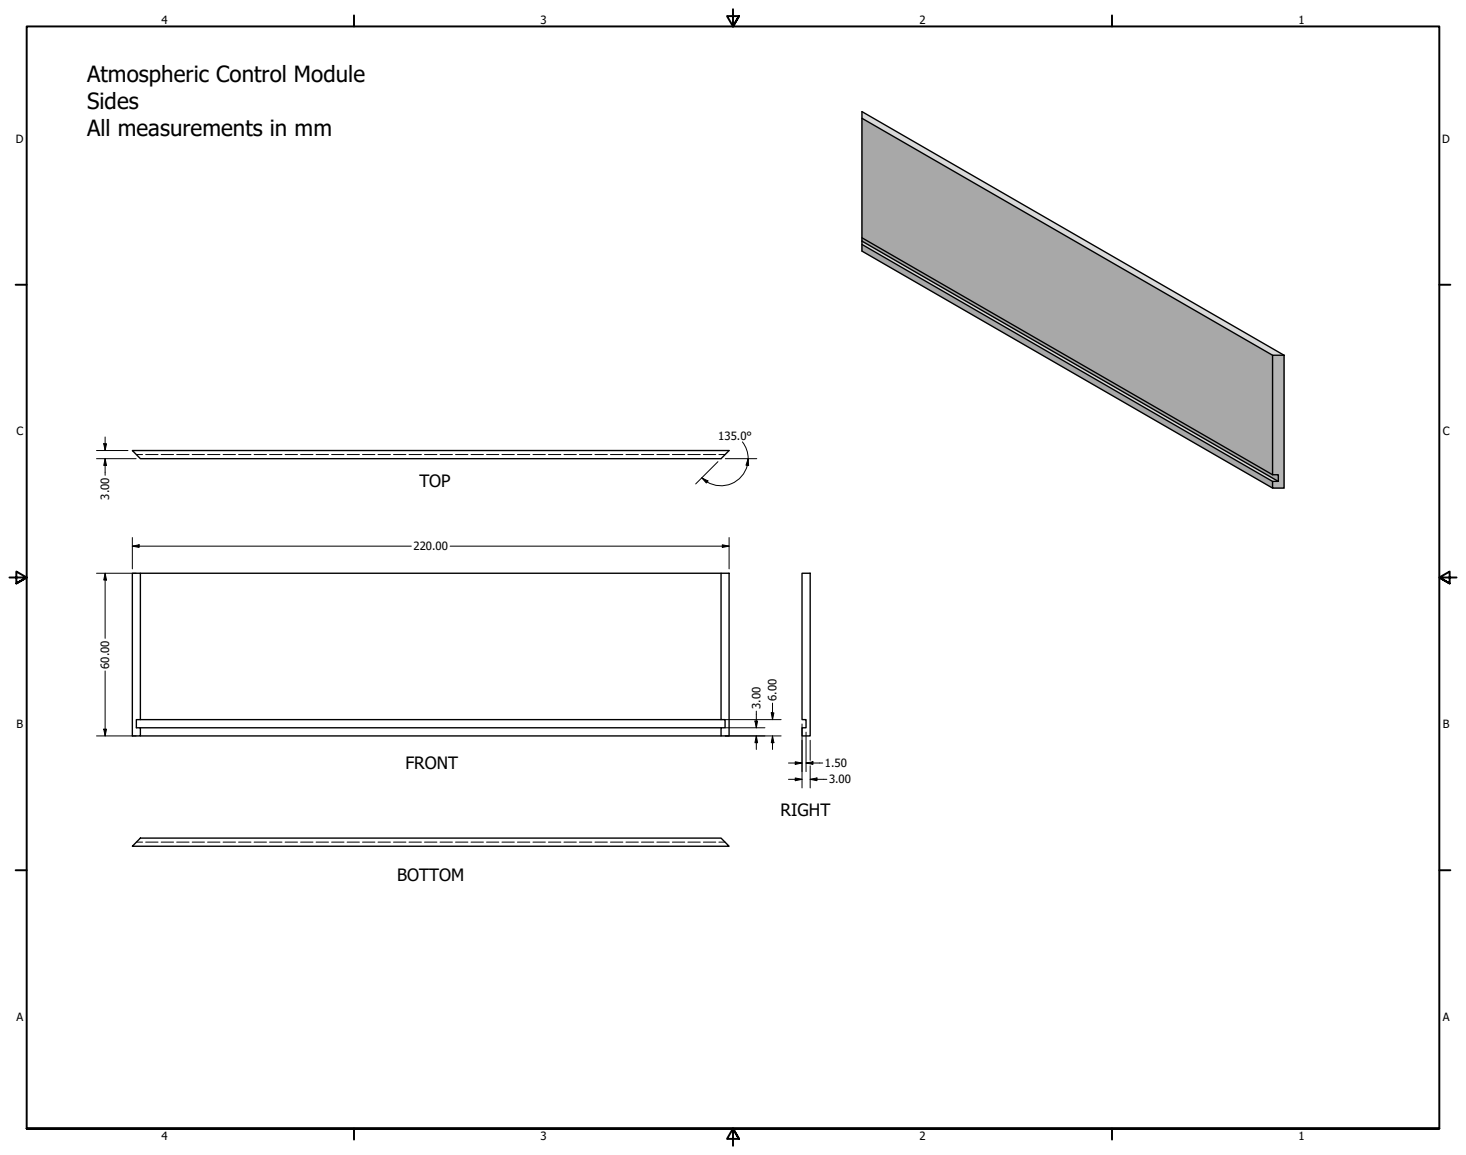
[picture p35: page 1]

Atmospheric Control Module
Sides
All measurements in mm
