AUautosynth/AU-ASM/A modular low-cost ASM demonstrated by ROMP/assets/CAD files/ACM_SupportColumn.pdf

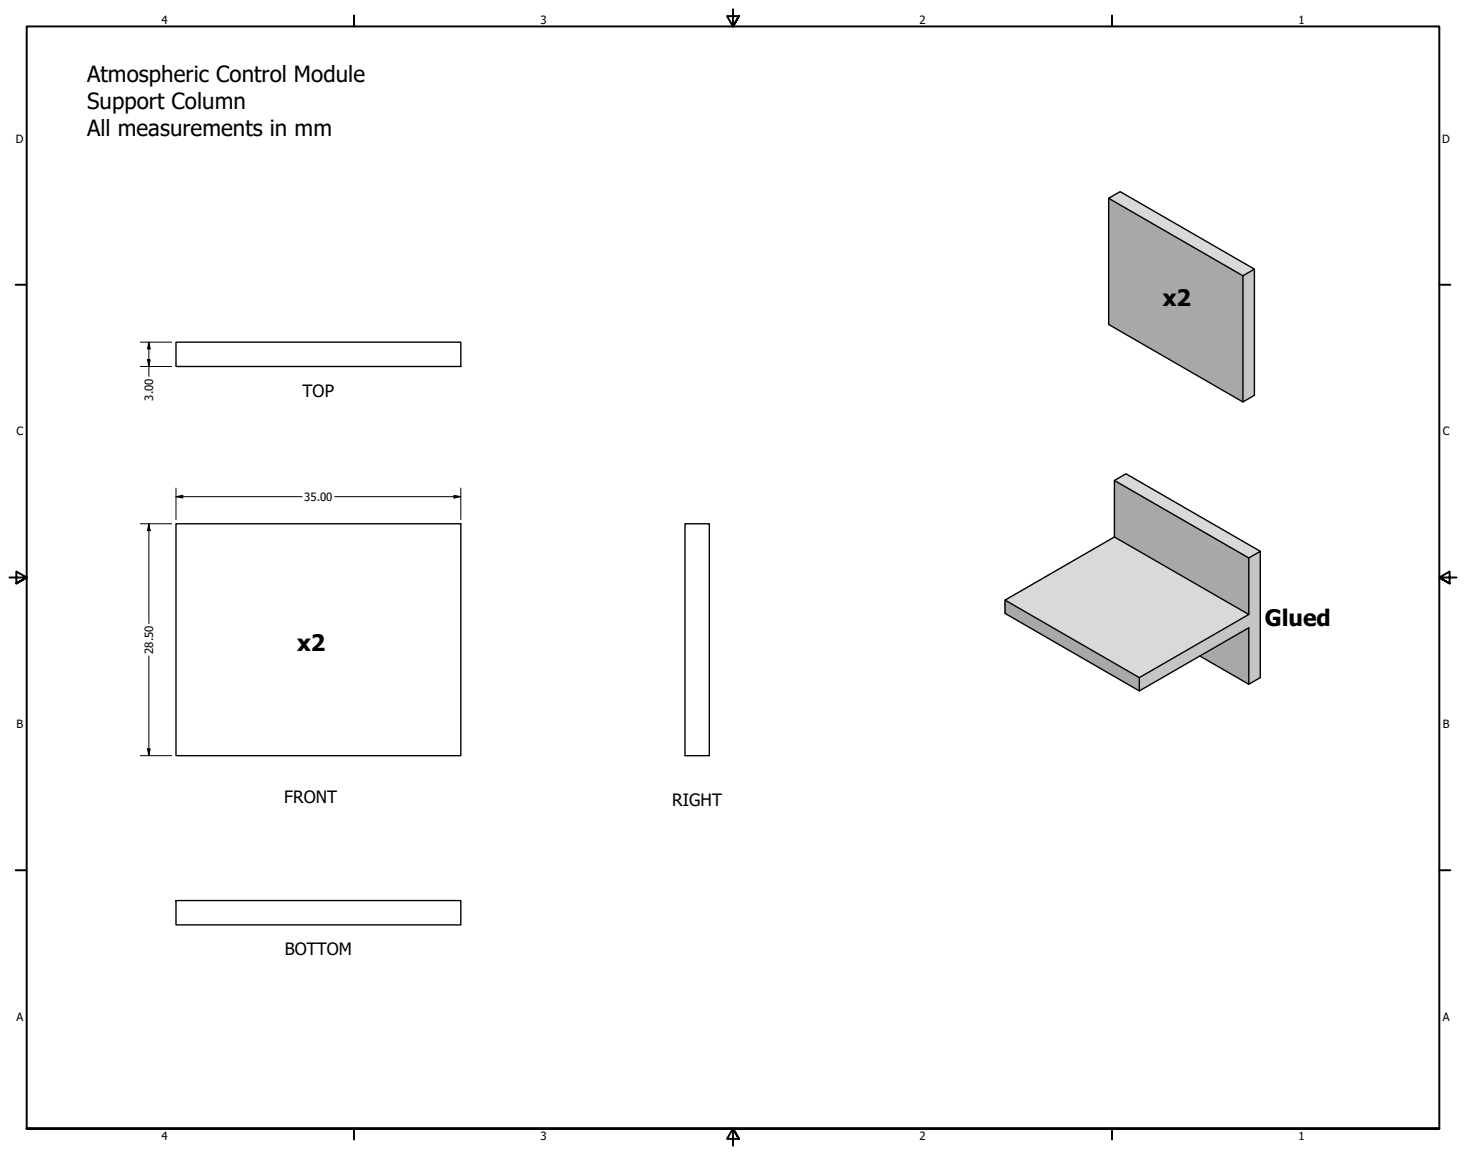
[picture p36: page 1]

Atmospheric Control Module
Support Column
All measurements in mm
