AUautosynth/AU-ASM/A modular low-cost ASM demonstrated by ROMP/assets/CAD files/DM_DirectMotorMount.pdf

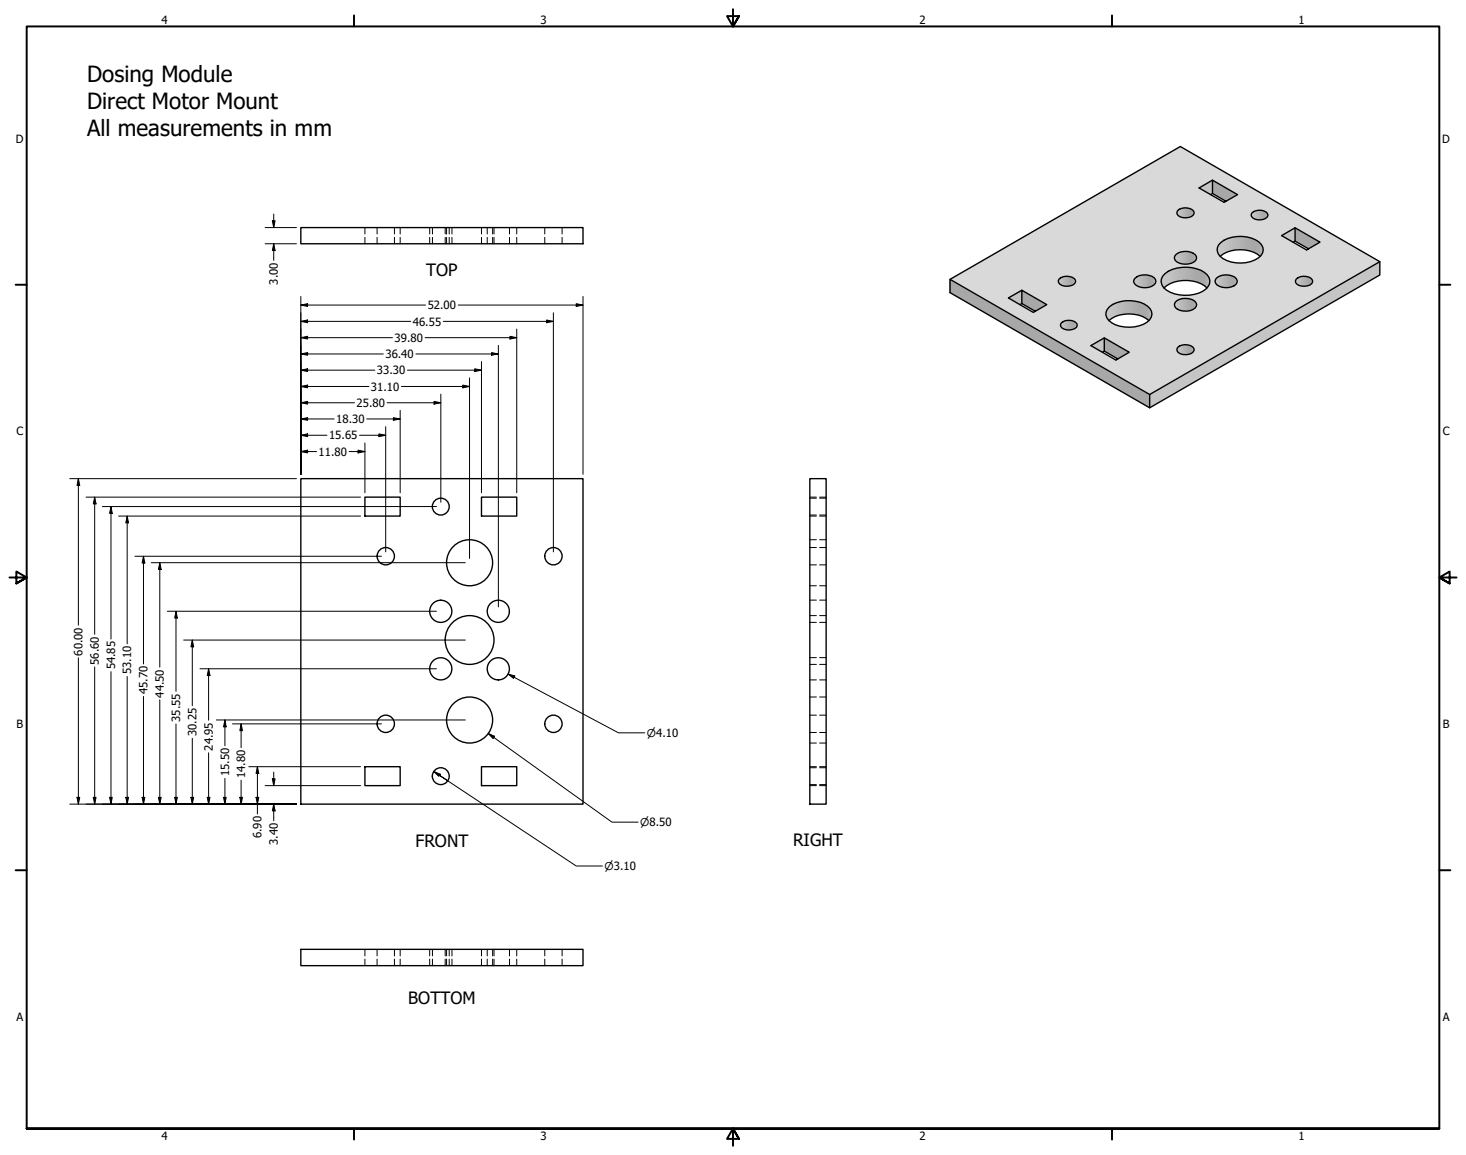
[picture p37: page 1]
All m
