AUautosynth/AU-ASM/A modular low-cost ASM demonstrated by ROMP/assets/CAD files/DM_Gantry.pdf

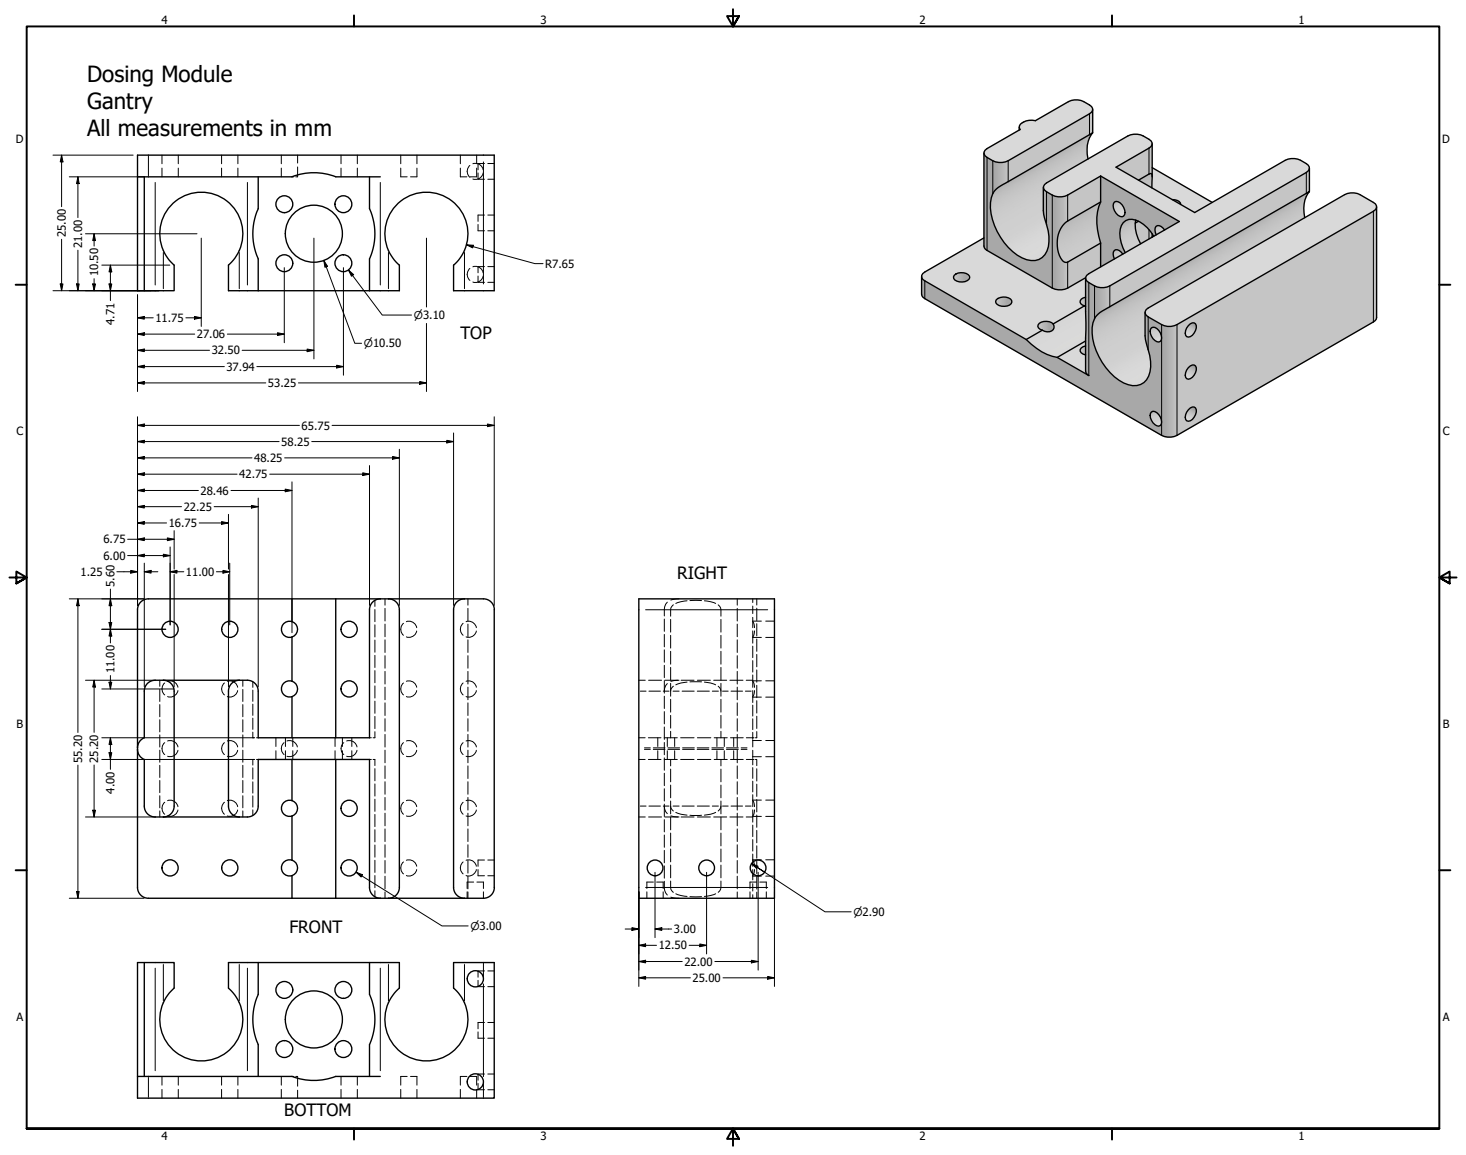
[picture p38: page 1]
All m
