AUautosynth/AU-ASM/A modular low-cost ASM demonstrated by ROMP/assets/CAD files/DM_NeedleHolder.pdf

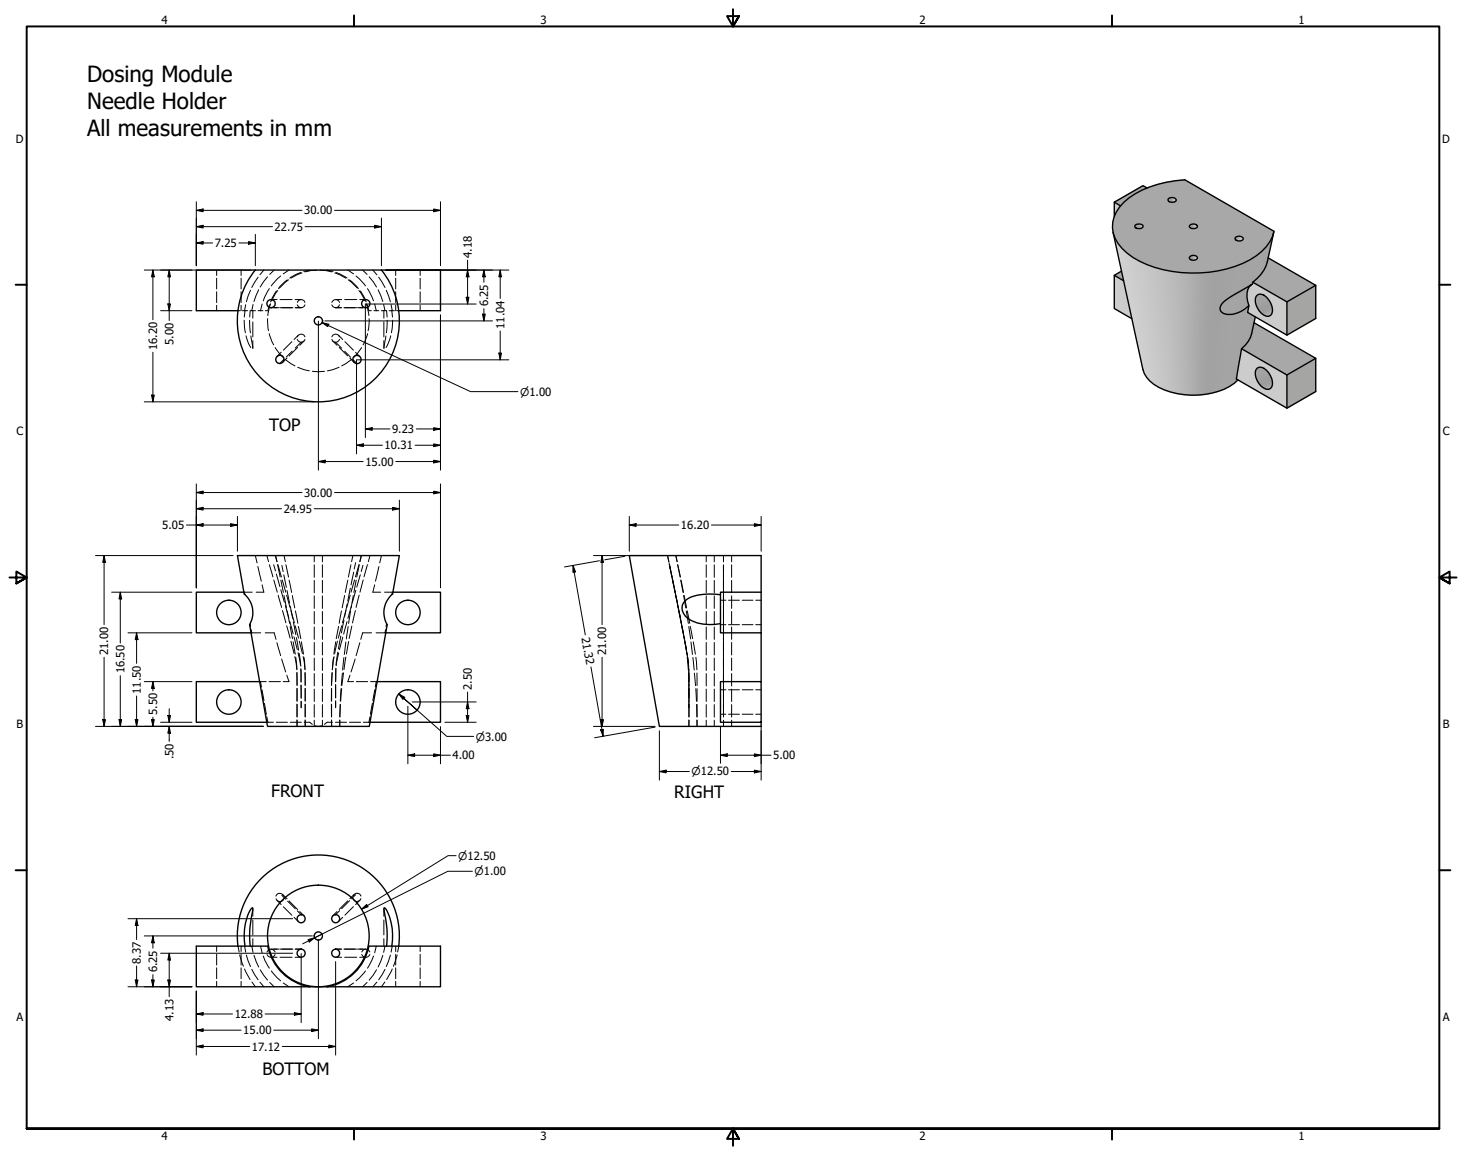
[picture p39: page 1]
All m
