AUautosynth/AU-ASM/A modular low-cost ASM demonstrated by ROMP/assets/CAD files/SM_DCholder.pdf

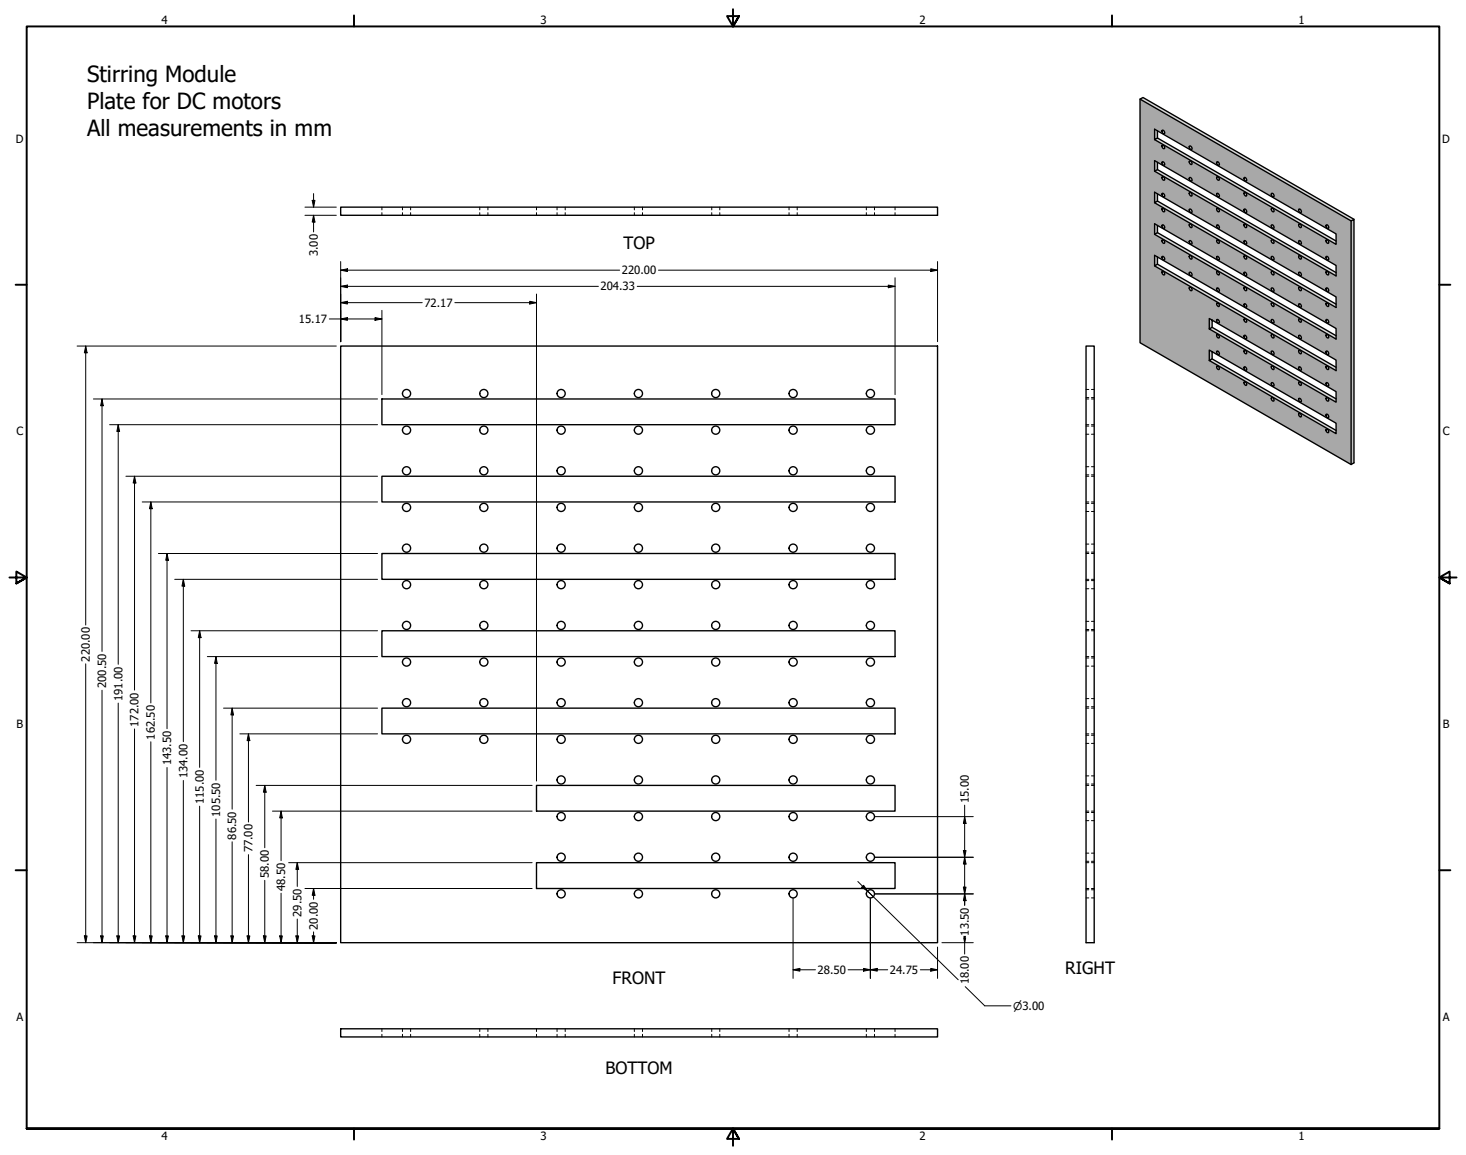
[picture p40: page 1]
All m
