AUautosynth/AU-ASM/A modular low-cost ASM demonstrated by ROMP/ASM files/Firmware folder/Marlin-1.1.x RAMPS 1.4 + RAMPSXB/Marlin/Configuration_adv.h

#define E0_AUTO_FAN_PIN -1
#define E1_AUTO_FAN_PIN -1
#define E2_AUTO_FAN_PIN -1
#define E3_AUTO_FAN_PIN -1
#define E4_AUTO_FAN_PIN -1
#define CHAMBER_AUTO_FAN_PIN -1
#define X_HOME_BUMP_MM 5
#define Y_HOME_BUMP_MM 5
#define Z_HOME_BUMP_MM 2
#define HOMING_BUMP_DIVISOR { 2, 2, 4 }  // Re-Bump Speed Divisor (Divides the Homing Feedrate)
#define MICROSTEP_MODES { 16, 16, 16, 16, 16 } // [1,2,4,8,16]
#define DIGIPOT_I2C_MOTOR_CURRENTS { 1.0, 1.0, 1.0, 1.0, 1.0, 1.0, 1.0, 1.0 }  //  AZTEEG_X3_PRO
