AUautosynth/AU-ASM/(commit log)

2023-05-10 Release version 1.0
    [ACM_BasePlate.ipt, ACM_InsertPlate.ipt, ACM_Lid.ipt, ACM_Side.ipt, ACM_SupportColumn1.ipt, ACM_SupportColumn2.ipt, Calibration template.xlsx, Configuration.h]
2023-05-10 Release version 1.0
    Added BoM
    [BoM.xlsx]
2023-10-03 Test af gitfront
    [ACM_BasePlate.ipt, ACM_InsertPlate.ipt, ACM_Lid.ipt, ACM_Side.ipt, ACM_SupportColumn1.ipt, ACM_SupportColumn2.ipt, BoM.xlsx, Calibration template.xlsx]
2023-10-03 Folders for NP added
    [A.csv, BoM.xlsx, CM_bottom.ipt, CM_corner_piece.ipt, CM_top.ipt, DH_Gantry.ipt, DH_NeedleHolder.ipt, DH_tube_fixture.ipt]
2023-10-03 Upadte for the gitronft
    [A.csv, ACM_BasePlate.ipt, ACM_InsertPlate.ipt, ACM_Lid.ipt, ACM_Side.ipt, ACM_SupportColumn1.ipt, ACM_SupportColumn2.ipt, BoM.xlsx]
2023-10-03 Switch the folders to match the new structure
    [A.csv, ACM_BasePlate.ipt, ACM_InsertPlate.ipt, ACM_Lid.ipt, ACM_Side.ipt, ACM_SupportColumn1.ipt, ACM_SupportColumn2.ipt, BoM.xlsx]
2023-10-06 ipt, stl and assembly updated
    Old files are removed at nad files are uploaded. They can now be found under assets and in IPT, STL and Assembly folders.
    [CM_Assembly.iam, CM_Assembly_Presentation.idw, CM_bottom.ipt, CM_bottom.stl, CM_corner_piece.ipt, CM_corner_piece.stl, CM_top.ipt, CM_top.stl]
2023-10-06 STL, IPT and Assembly uploaded for the Perry Pump
    CAD files added under assets, and includes STL, IPT and assembly
    [Perry_Assembly.iam, Perry_body.ipt, Perry_body.stl, Perry_hanger_left.ipt, Perry_hanger_left.stl, Perry_hanger_right.ipt, Perry_hanger_right.stl, Perry_plunge_fitter_10ml.ipt]
2023-10-06 Bugfix
    Fixed a bug, which resulted in the protocol creator "forgetting" all but the first solution column.
    Aditionally, a ".py" check has been written to ensure that the method file won't have more than one ".py" after its name.
    [experiment_window.py, protocol_creator.py]
